Makertech3D/Proforge-2S/README.md

# Proforge-2S
Proforge 2S related files and dowloads.
