Makertech3D/Proforge-2S/Metal Parts/Endstop Trigger.STEP

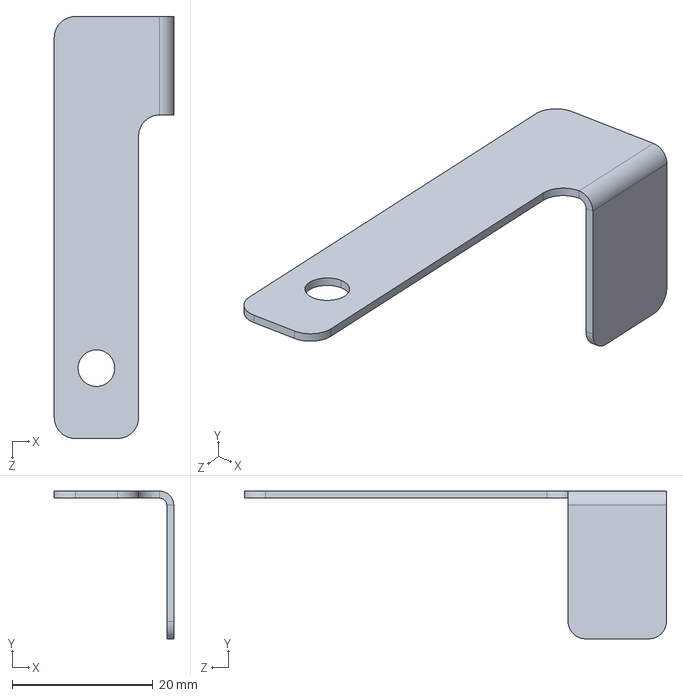
[picture p2: CAD file, 2020-06-16]
Metal Parts/Endstop Trigger.STEP
17.0 x 21.0 x 60.0 mm
