Makertech3D/Proforge-2S/Metal Parts/Pi Cam Case.STEP

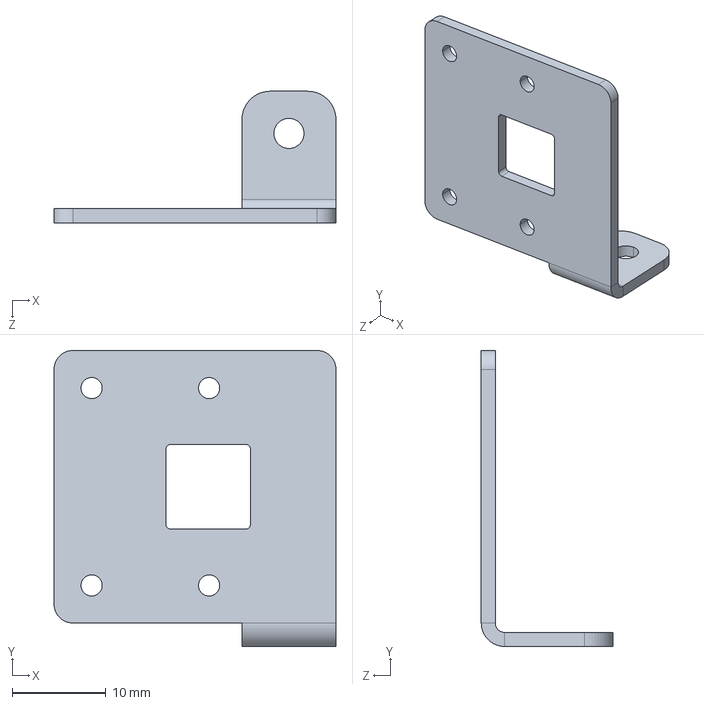
[picture p3: CAD file, 2020-06-16]
Metal Parts/Pi Cam Case.STEP
30.0 x 31.5 x 14.0 mm
