Makertech3D/Proforge-2S/Metal Parts/Y-Idler Support Bracket.STEP

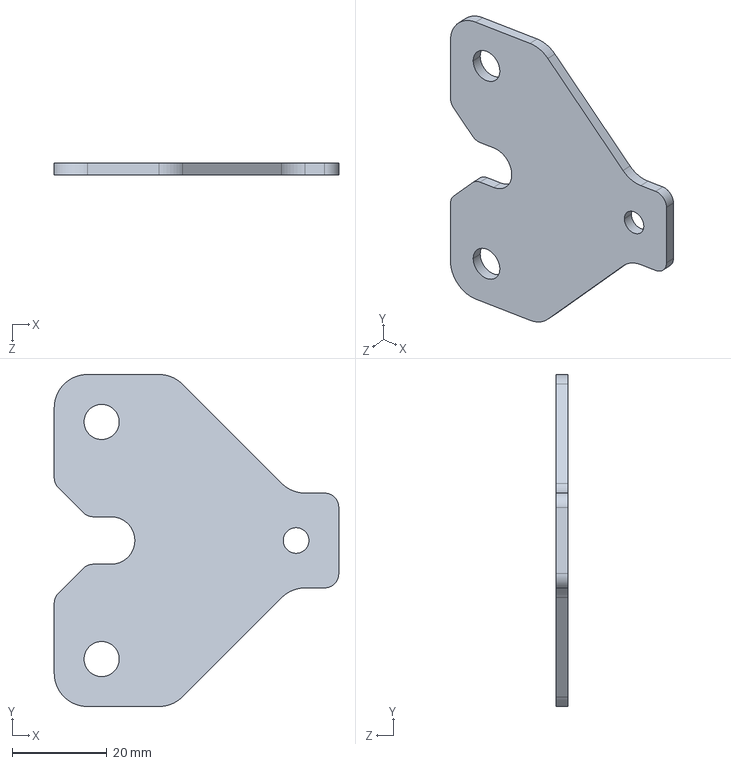
[picture p4: CAD file, 2020-06-16]
Metal Parts/Y-Idler Support Bracket.STEP
60.0 x 70.0 x 2.50 mm
