Makertech3D/Proforge-2S/Metal Parts/DSE Back Plate.STEP

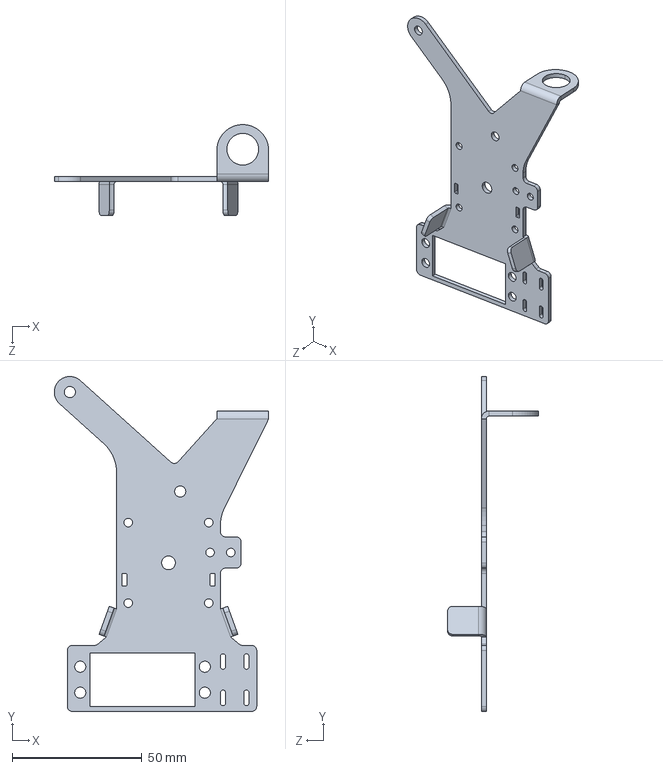
[picture p5: CAD file, 2020-06-16]
Metal Parts/DSE Back Plate.STEP
82.6 x 129.0 x 35.0 mm
