Makertech3D/Proforge-2S/Metal Parts/Y-Idler.STEP

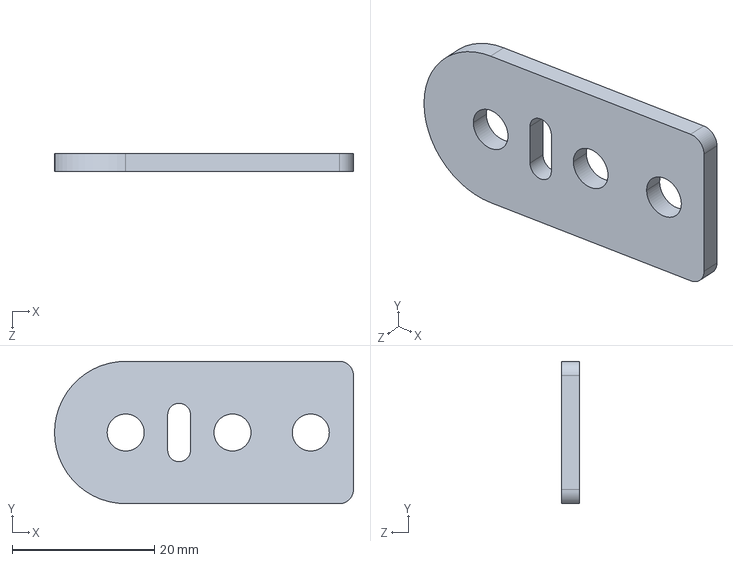
[picture p6: CAD file, 2020-06-16]
Metal Parts/Y-Idler.STEP
42.0 x 20.0 x 2.50 mm
