Makertech3D/Proforge-2S/Metal Parts/DSE 2nd Fan Mount.STEP

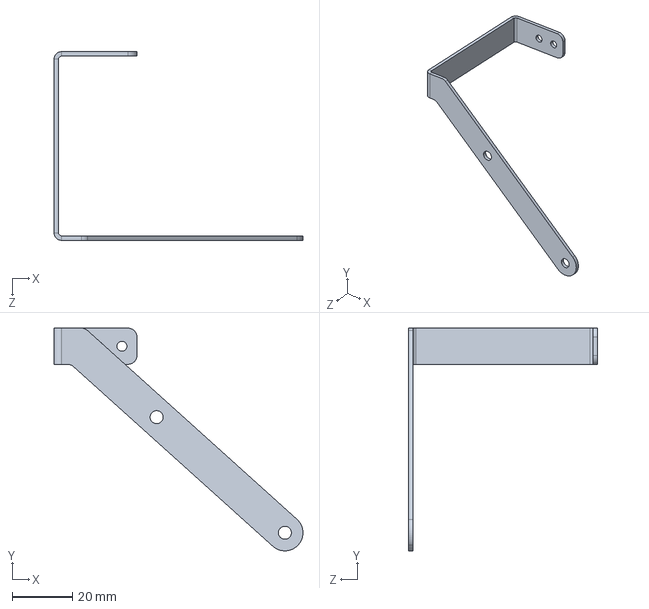
[picture p7: CAD file, 2020-06-16]
Metal Parts/DSE 2nd Fan Mount.STEP
82.5 x 73.8 x 62.5 mm
