Makertech3D/Proforge-2S/Metal Parts/Base Left Panel.STEP

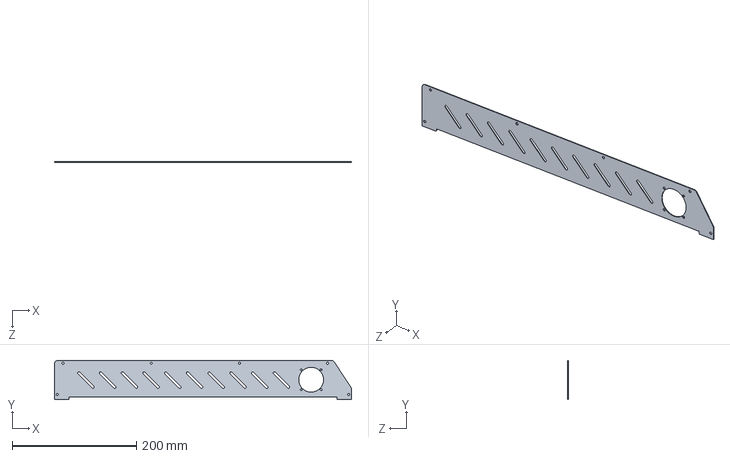
[picture p8: CAD file, 2020-06-16]
Metal Parts/Base Left Panel.STEP
478.6 x 63.0 x 1.00 mm
