Makertech3D/Proforge-2S/Metal Parts/Support Beam.STEP

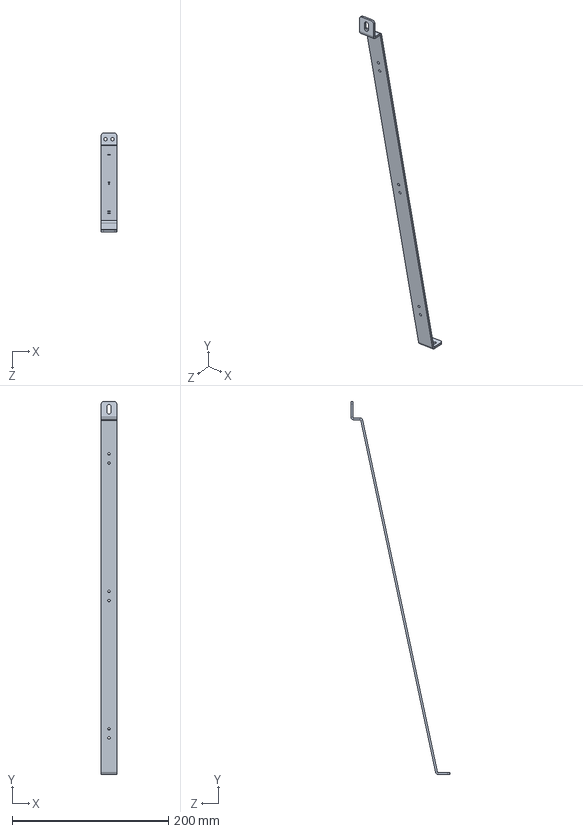
[picture p9: CAD file, 2020-06-16]
Metal Parts/Support Beam.STEP
20.0 x 477.8 x 127.0 mm
