Makertech3D/Proforge-2S/Metal Parts/Tool Carriage.STEP

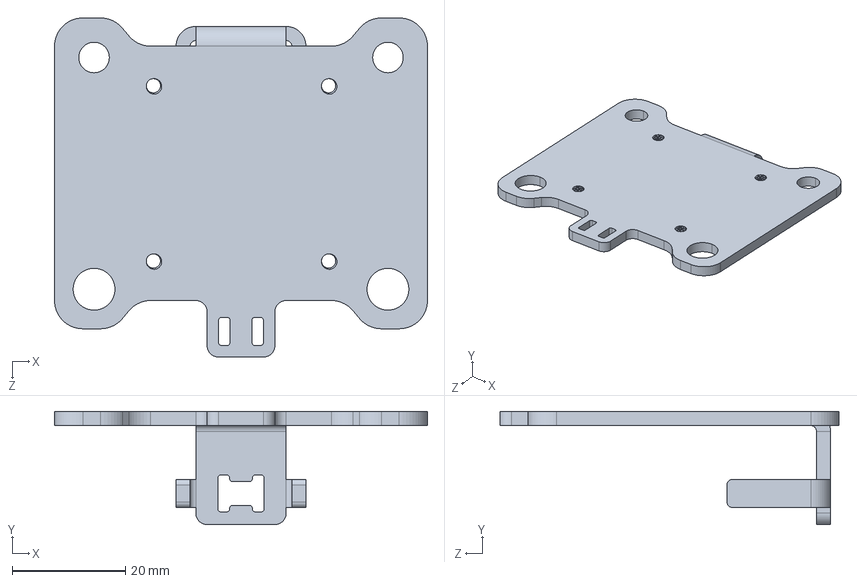
[picture p10: CAD file, 2020-06-16]
Metal Parts/Tool Carriage.STEP
66.0 x 20.0 x 60.0 mm
