Makertech3D/Proforge-2S/Metal Parts/DSE Ooze Shield.STEP

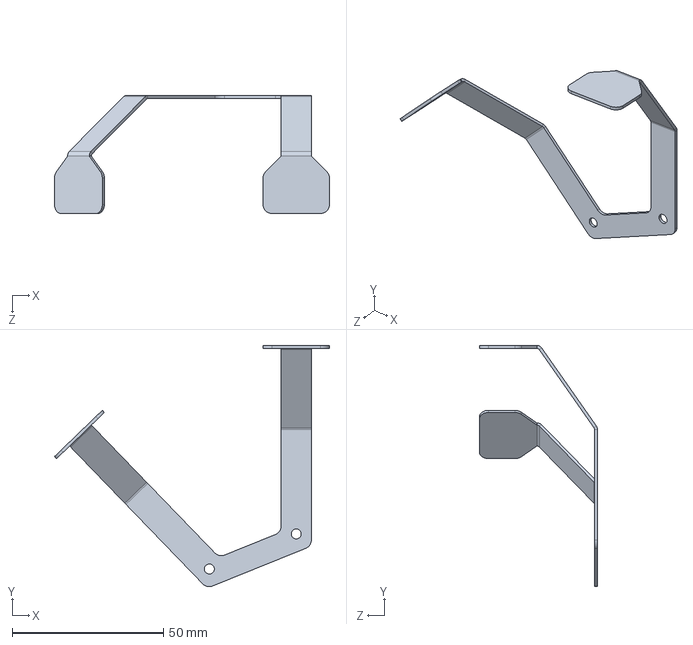
[picture p12: CAD file, 2020-06-16]
Metal Parts/DSE Ooze Shield.STEP
91.0 x 79.8 x 39.1 mm
