Makertech3D/Proforge-2S/Metal Parts/Z-Axis Support Bracket.STEP

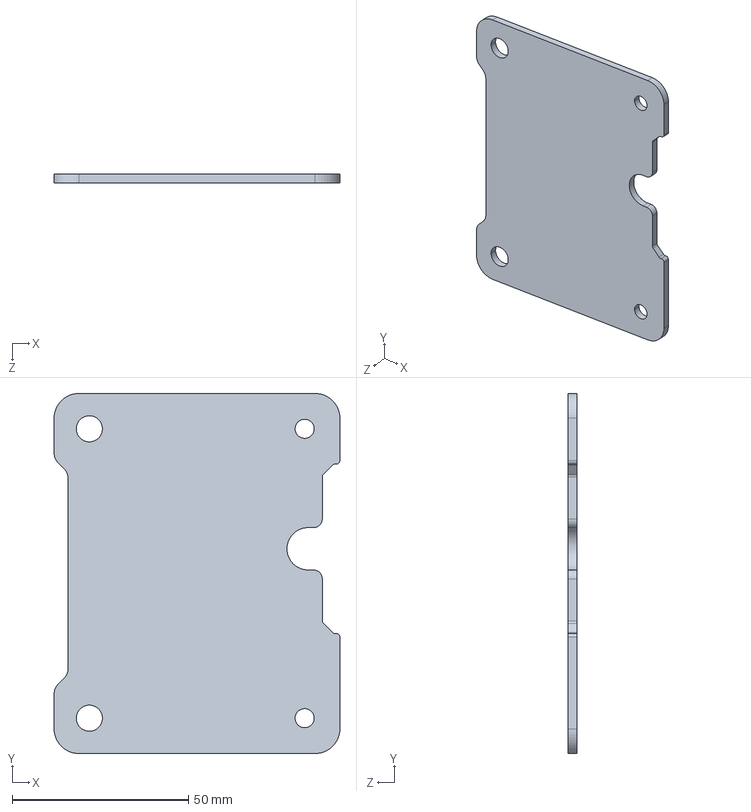
[picture p13: CAD file, 2020-06-16]
Metal Parts/Z-Axis Support Bracket.STEP
81.0 x 102.0 x 2.50 mm
