Makertech3D/Proforge-2S/Metal Parts/Extrusion bracket.STEP

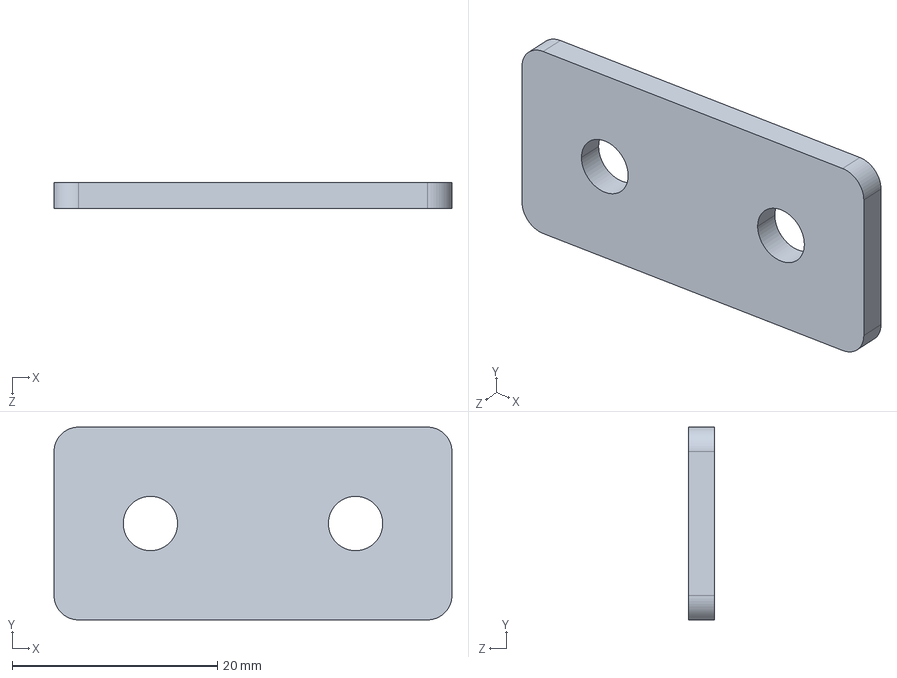
[picture p14: CAD file, 2020-06-16]
Metal Parts/Extrusion bracket.STEP
38.8 x 18.8 x 2.50 mm
