Makertech3D/Proforge-2S/Metal Parts/Print Platform.STEP

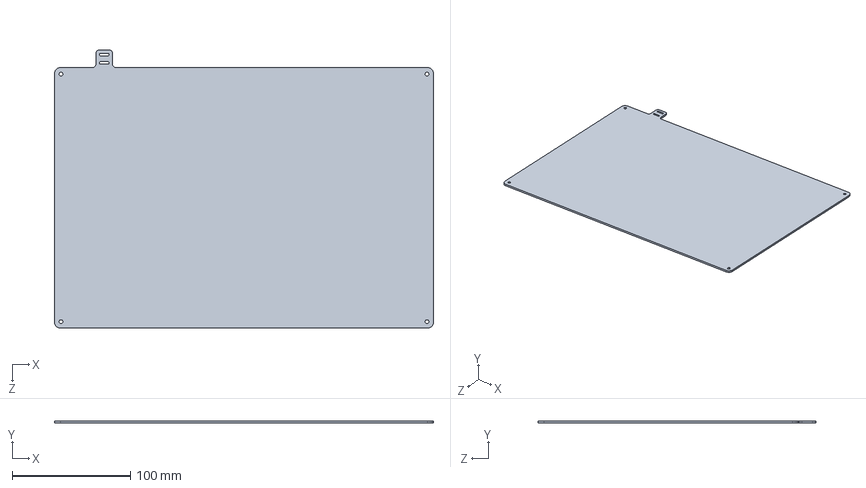
[picture p15: CAD file, 2020-06-16]
Metal Parts/Print Platform.STEP
320.0 x 2.00 x 235.0 mm
