Makertech3D/Proforge-2S/Metal Parts/Base.STEP

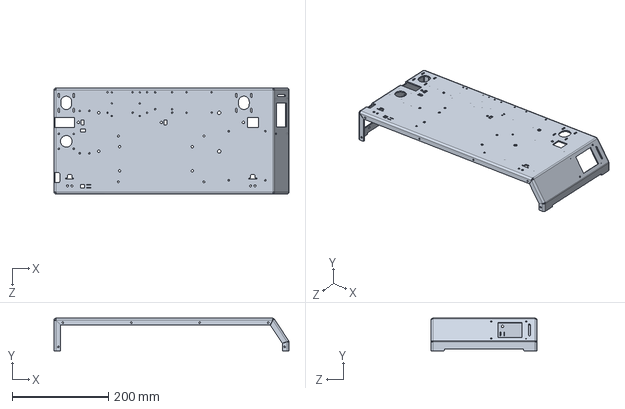
[picture p16: CAD file, 2020-06-16]
Metal Parts/Base.STEP
487.6 x 67.5 x 220.0 mm
