Makertech3D/Proforge-2S/Metal Parts/Z-Axis Bracket.STEP

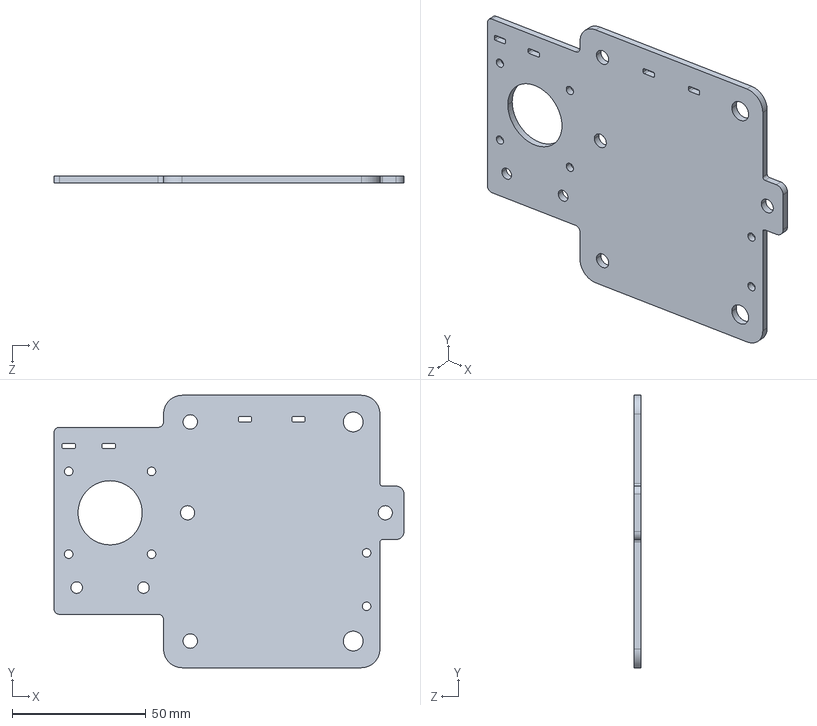
[picture p17: CAD file, 2020-06-16]
Metal Parts/Z-Axis Bracket.STEP
131.0 x 102.0 x 2.50 mm
