Makertech3D/Proforge-2S/Metal Parts/DSE Hotend Mount.STEP

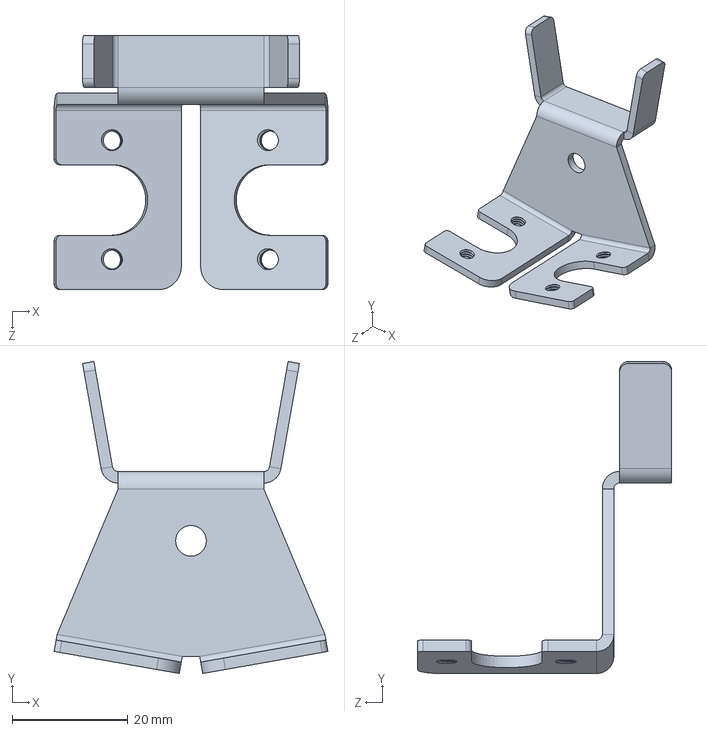
[picture p18: CAD file, 2020-06-16]
Metal Parts/DSE Hotend Mount.STEP
47.4 x 54.0 x 44.0 mm
