Makertech3D/Proforge-2S/Metal Parts/Y-Idler Guided.STEP

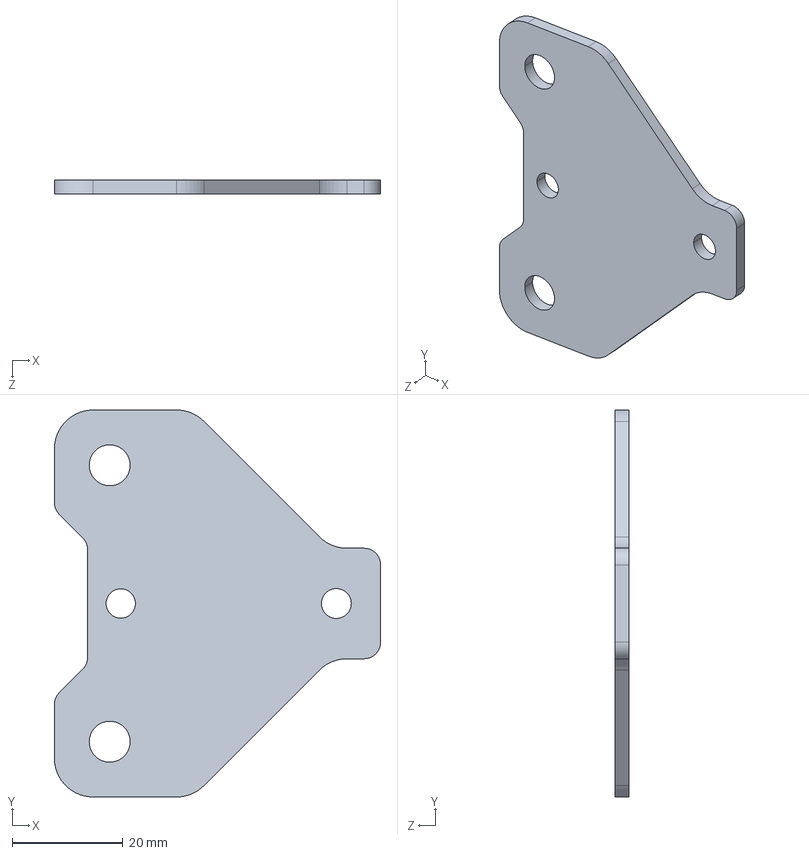
[picture p19: CAD file, 2020-06-16]
Metal Parts/Y-Idler Guided.STEP
59.0 x 70.0 x 2.50 mm
