Makertech3D/Proforge-2S/Metal Parts/Pi Cam Mount.STEP

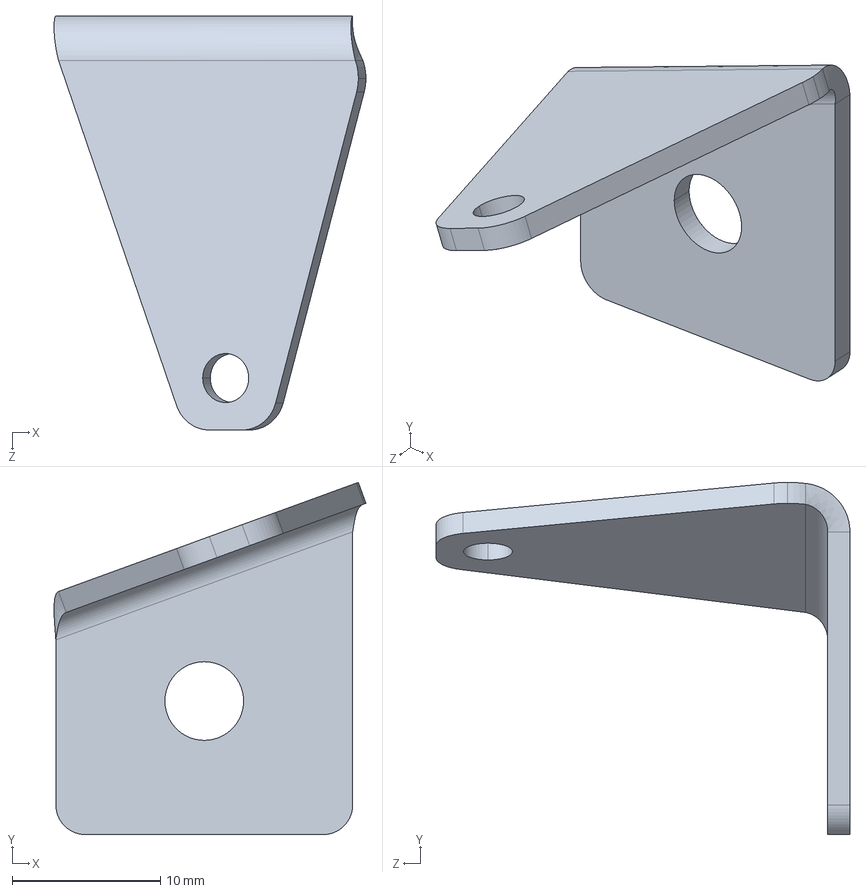
[picture p20: CAD file, 2020-06-16]
Metal Parts/Pi Cam Mount.STEP
21.0 x 23.7 x 27.9 mm
