Makertech3D/Proforge-2S/Metal Parts/Spool Holder.STEP

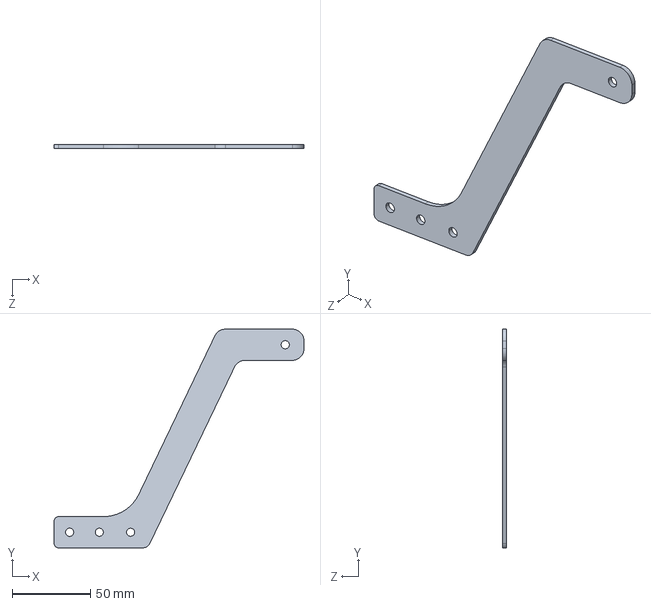
[picture p21: CAD file, 2020-06-16]
Metal Parts/Spool Holder.STEP
160.0 x 140.0 x 2.50 mm
