Makertech3D/Proforge-2S/Metal Parts/Hotend Mount.STEP

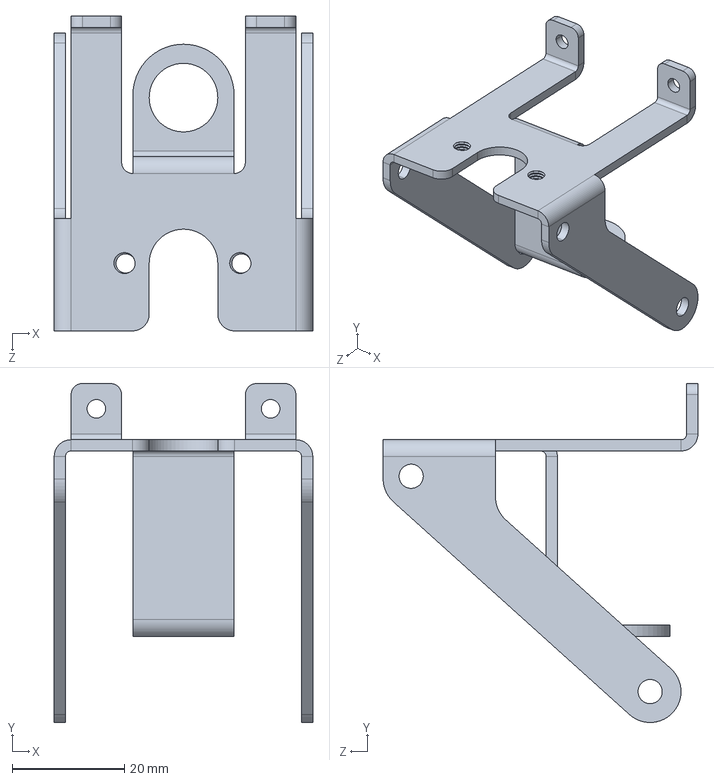
[picture p22: CAD file, 2020-06-16]
Metal Parts/Hotend Mount.STEP
46.0 x 60.3 x 56.0 mm
