Makertech3D/Proforge-2S/Metal Parts/Feeder Mount.STEP

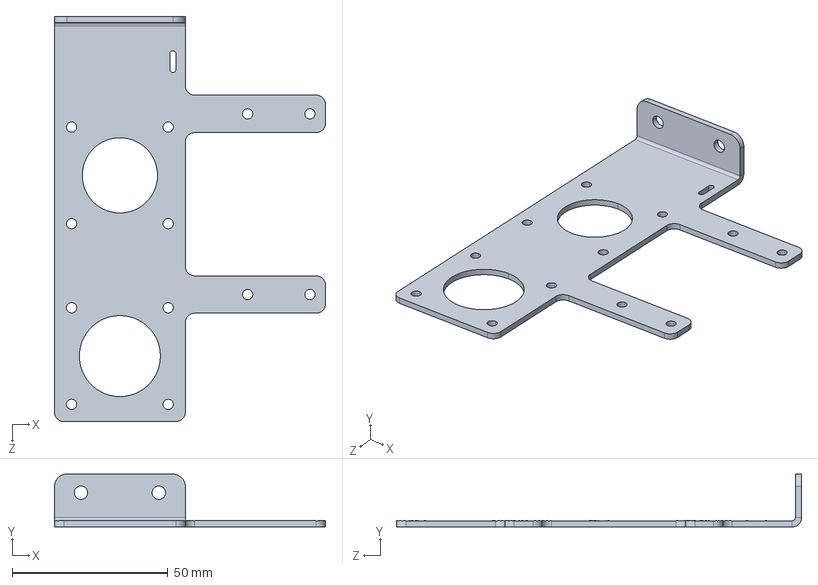
[picture p23: CAD file, 2020-06-16]
Metal Parts/Feeder Mount.STEP
87.0 x 17.0 x 130.0 mm
