Makertech3D/Proforge-2S/Metal Parts/Base Left Panel.PDF

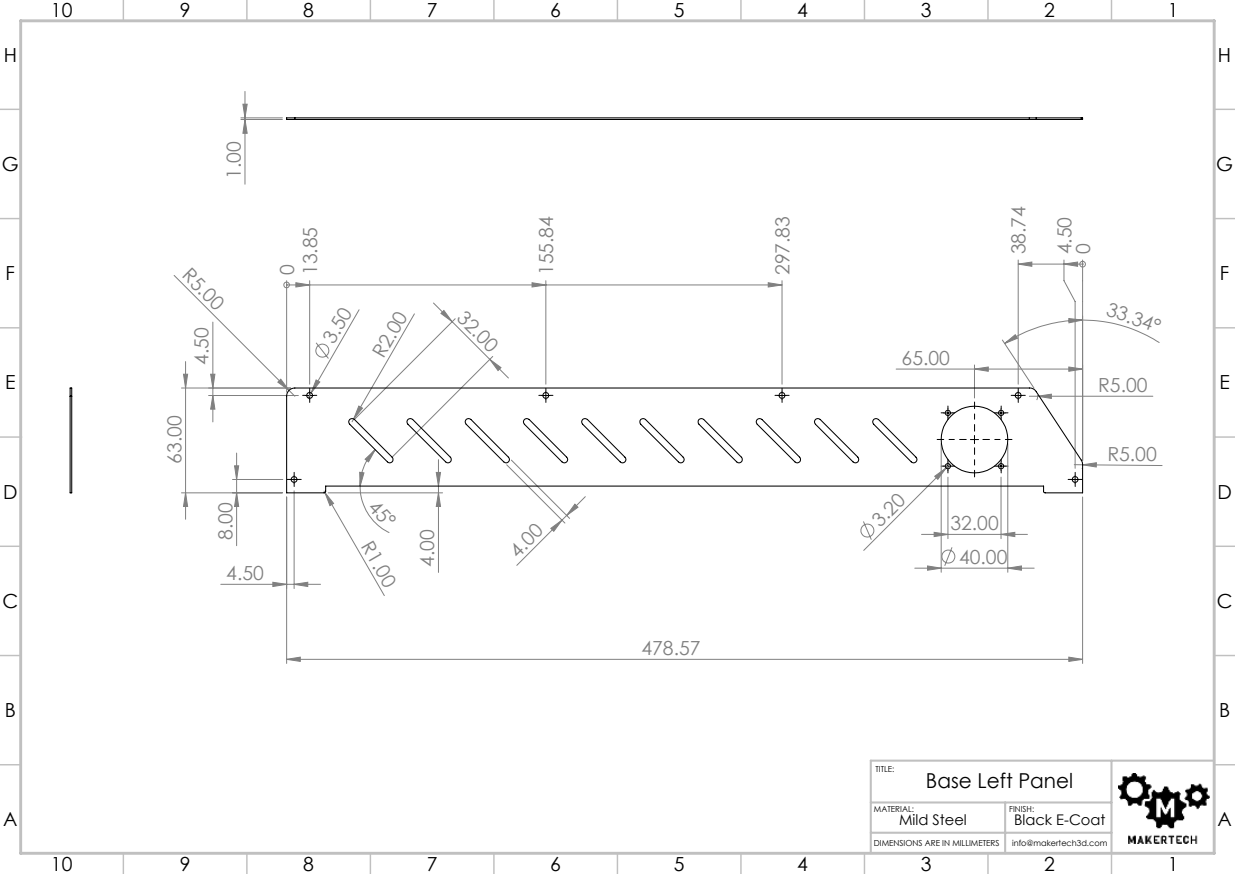
[picture p24: page 1]
Mild Steel

TITLE: Base Left Panel

MATERIAL: | FINISH: Black E-Coat

DIMENSIONS ARE IN MILLIMETERS | info@makertech3d.com
