Makertech3D/Proforge-2S/Metal Parts/Base Right Panel.PDF

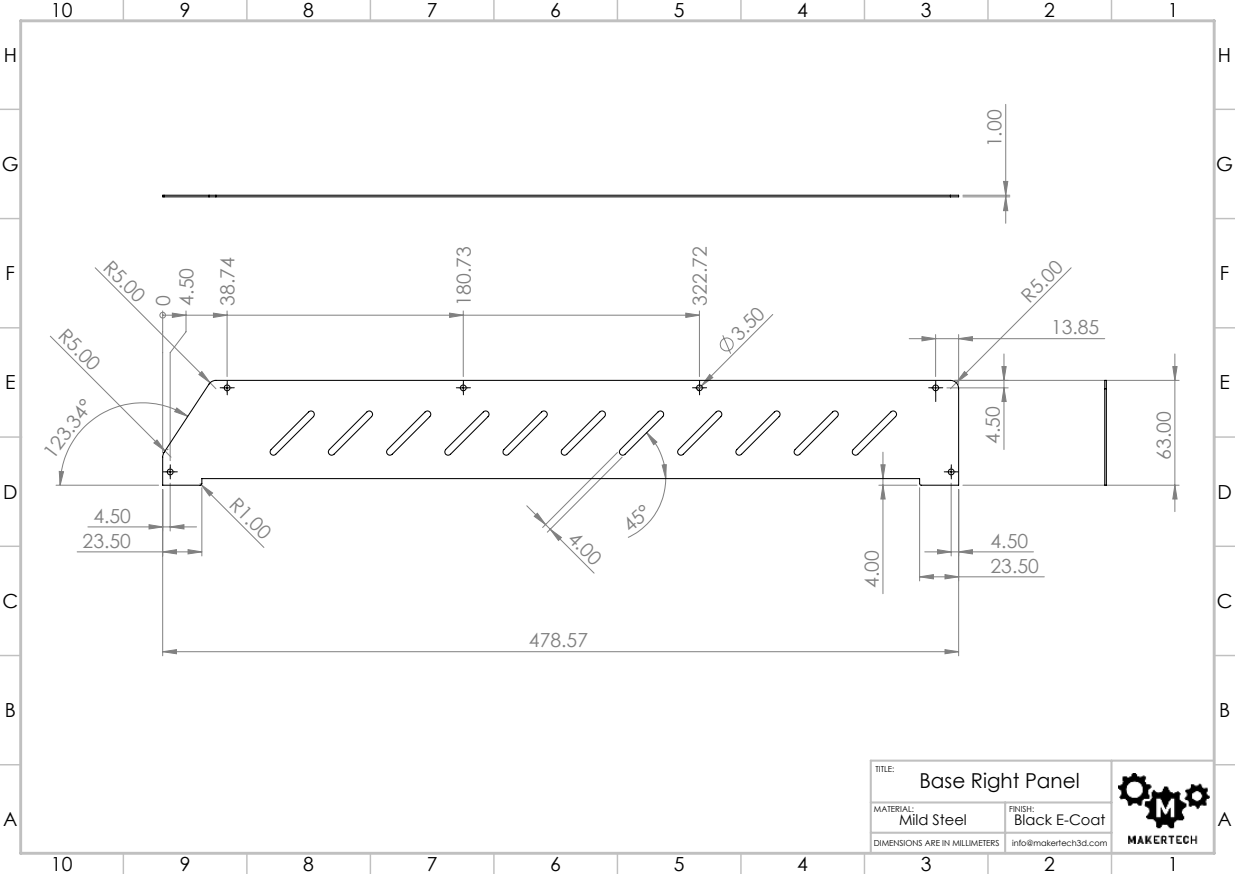
[picture p25: page 1]
Mild Steel

TITLE: Base Right Panel

MATERIAL: | FINISH: Black E-Coat

DIMENSIONS ARE IN MILLIMETERS | info@makertech3d.com
