Makertech3D/Proforge-2S/Metal Parts/Base.PDF

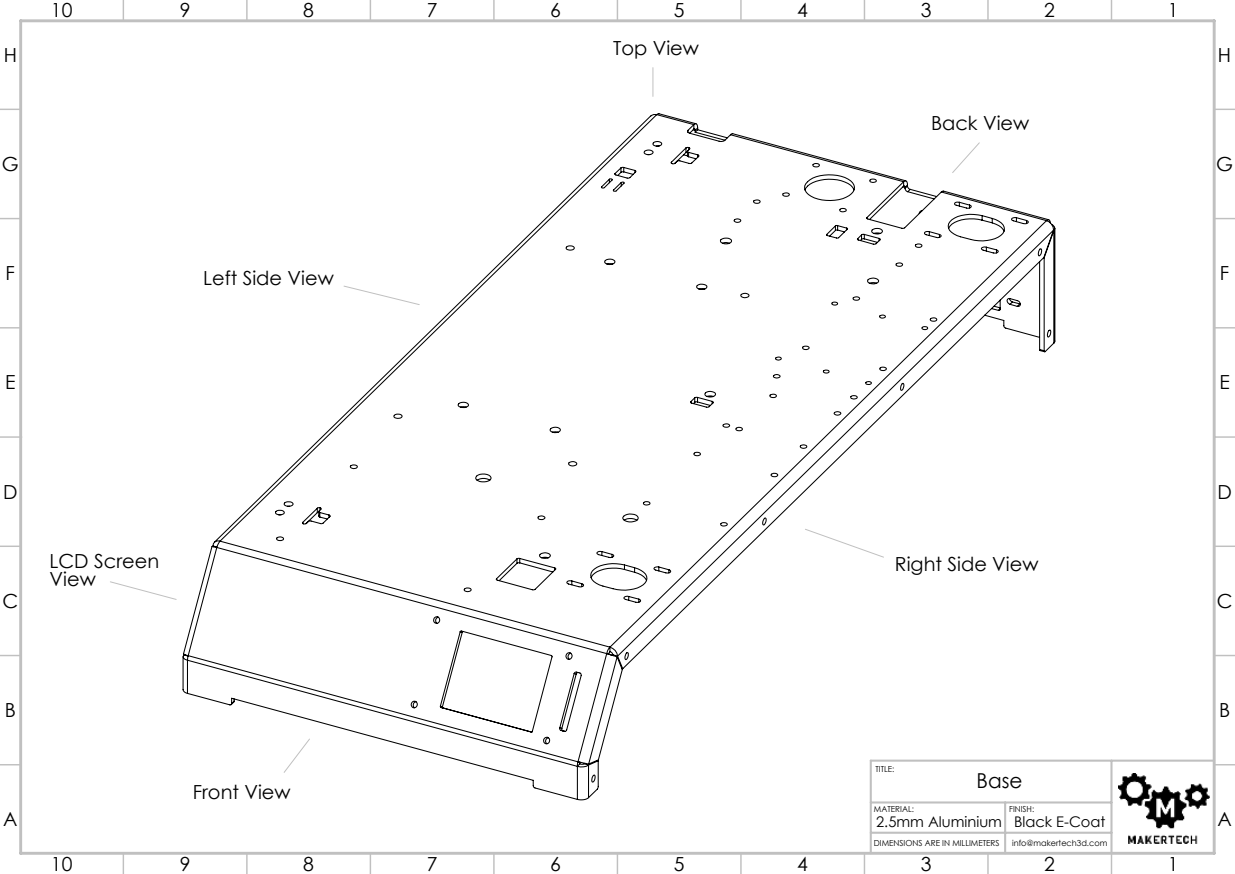
[picture p26: page 1]
Front View; Back View; Top View; LCD Screen; 2.5mm Aluminium; Black E-Coat

Left Side View

Right Side View

TITLE: Base

MATERIAL: | FINISH:

DIMENSIONS ARE IN MILLIMETERS | info@makertech3d.com

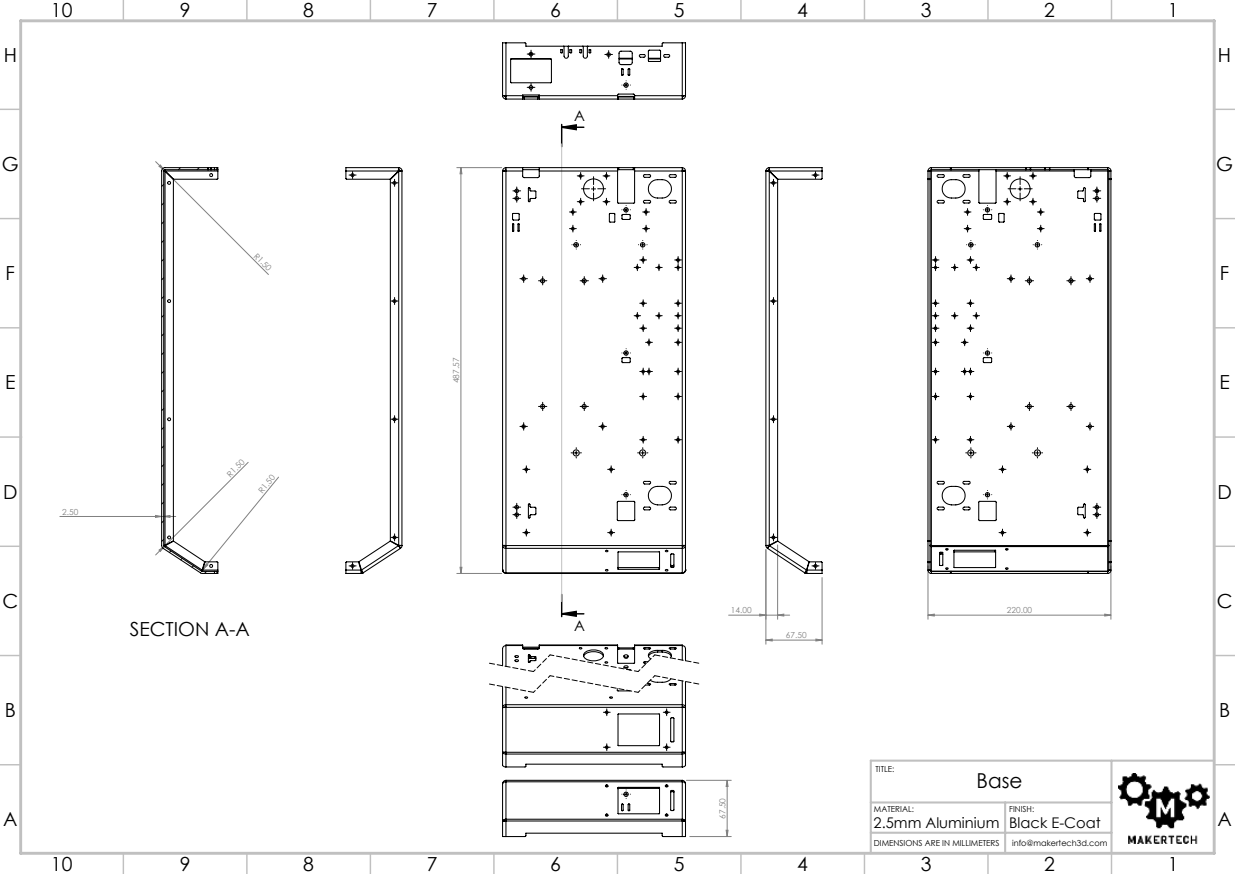
[picture p27: page 2]
SECTION A-A; 2.5mm Aluminium

TITLE: Base

Black E-Coat

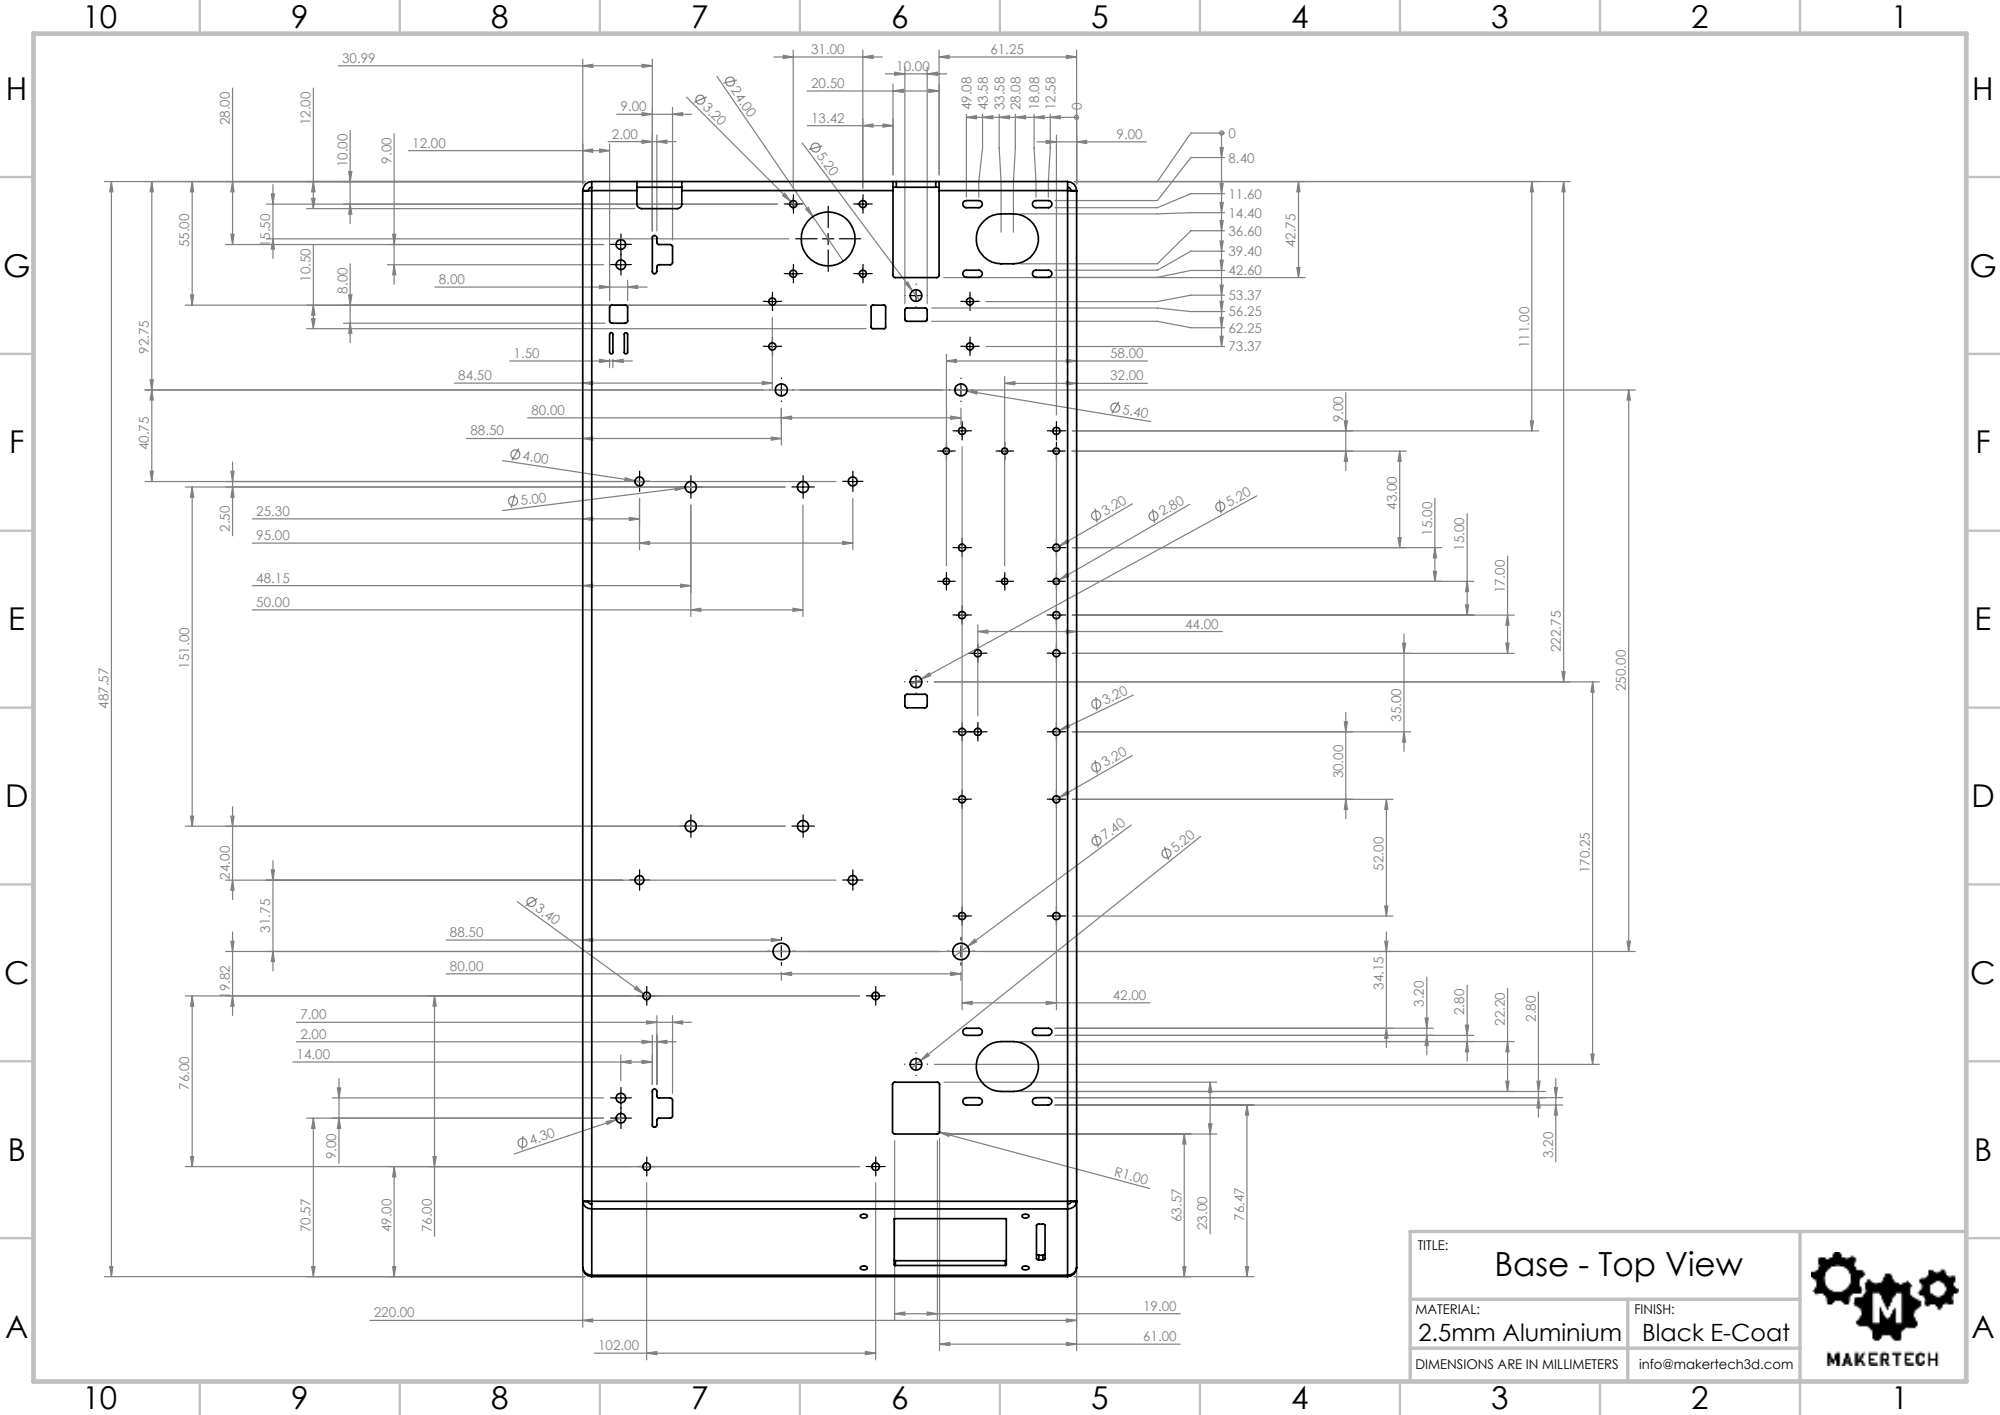
[picture p28: page 3]
2.5mm Aluminium; Black E-Coat

TITLE:
Base - Top View

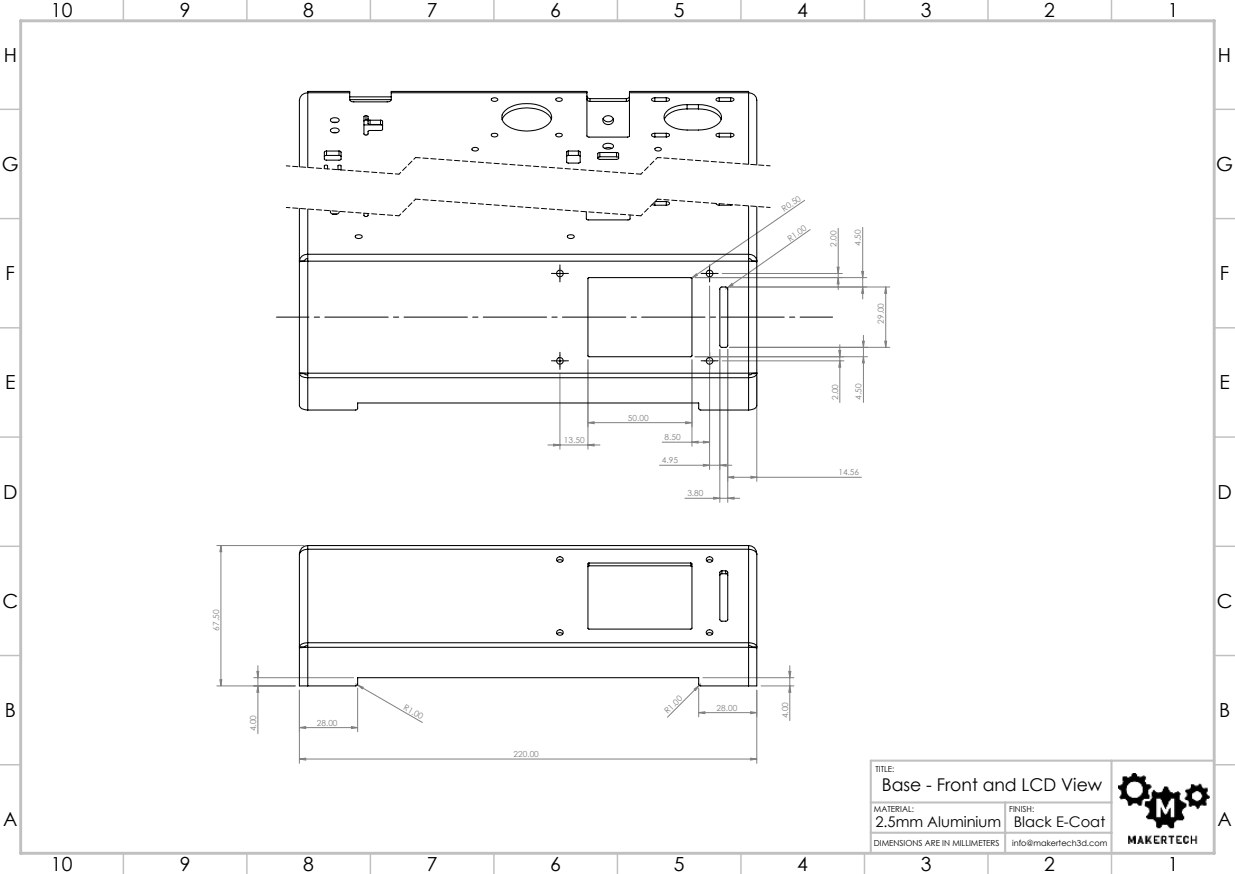
[picture p29: page 4]

TITLE:
Base - Front and LCD View

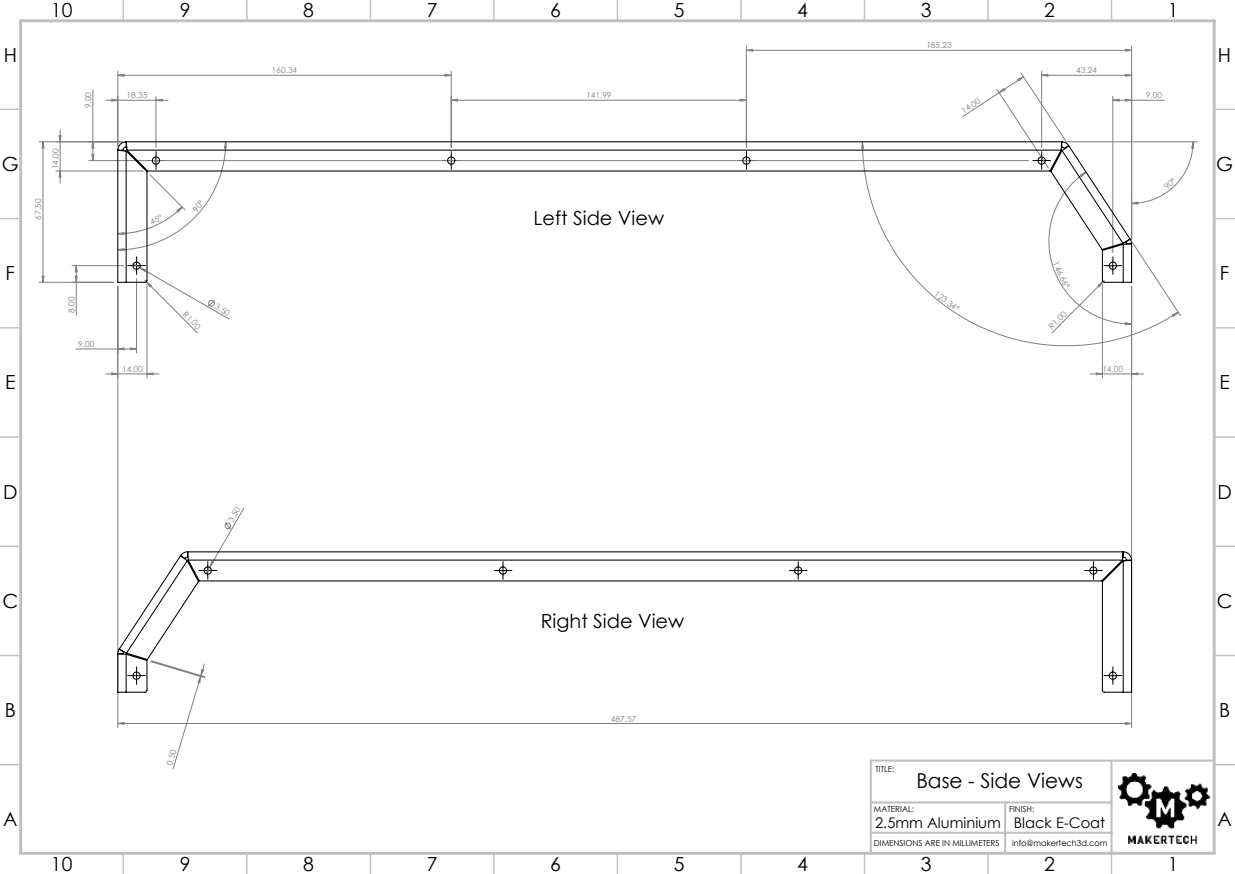
[picture p30: page 5]

Left Side View

Right Side View

TITLE:
Base - Side Views

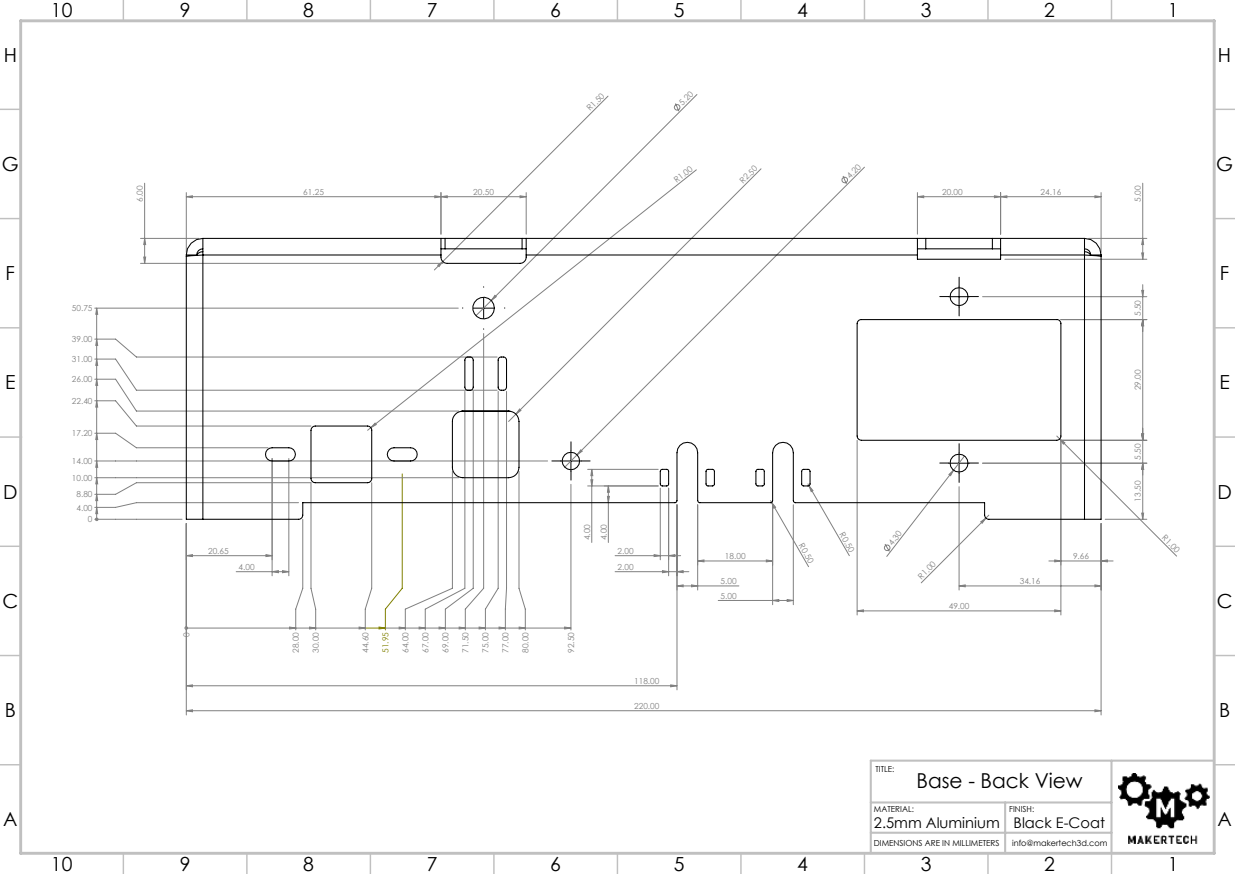
[picture p31: page 6]

TITLE:
Base - Back View
