Makertech3D/Proforge-2S/Metal Parts/DSE 2nd Fan Mount.PDF

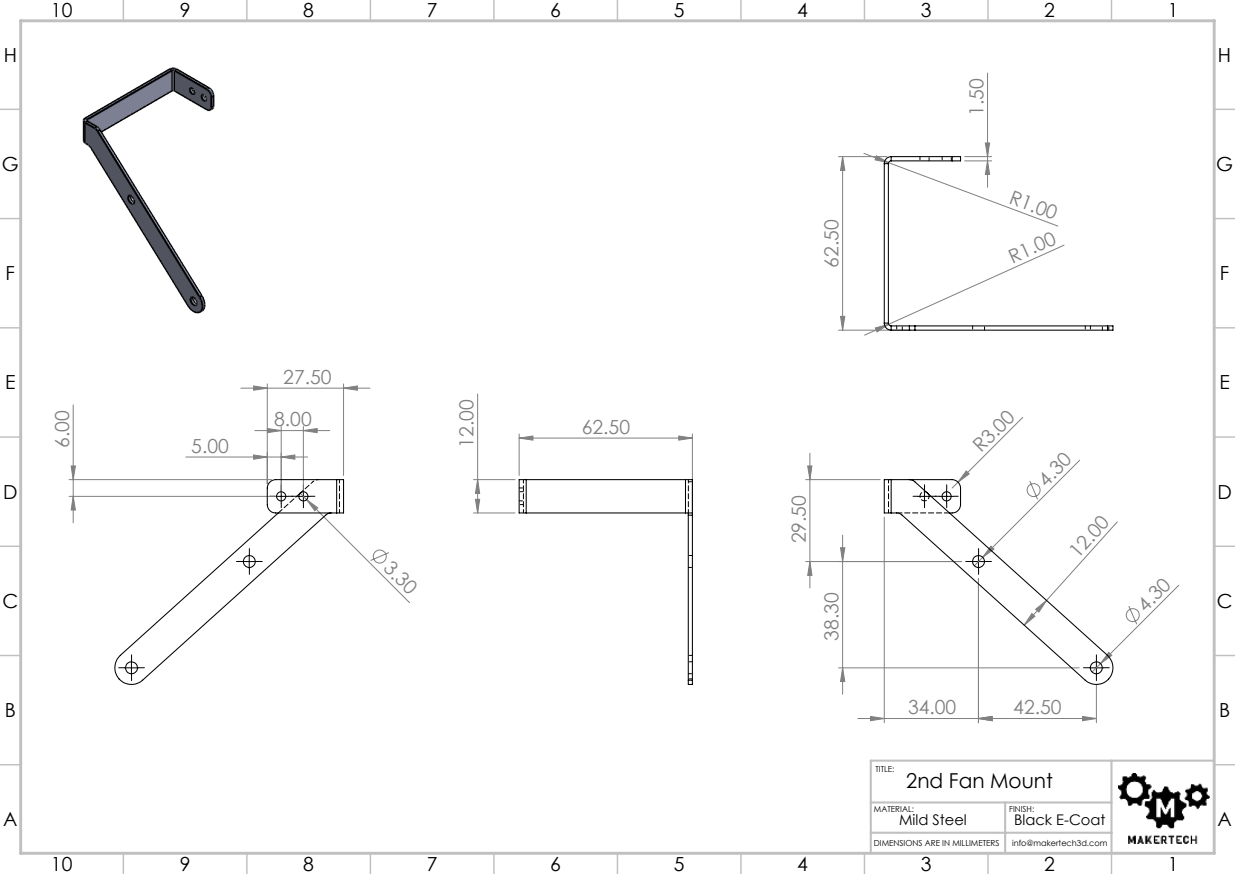
[picture p32: page 1]
Mild Steel

TITLE: 2nd Fan Mount

MATERIAL: | FINISH: Black E-Coat

DIMENSIONS ARE IN MILLIMETERS | info@makertech3d.com
