Makertech3D/Proforge-2S/Metal Parts/DSE Back Plate.PDF

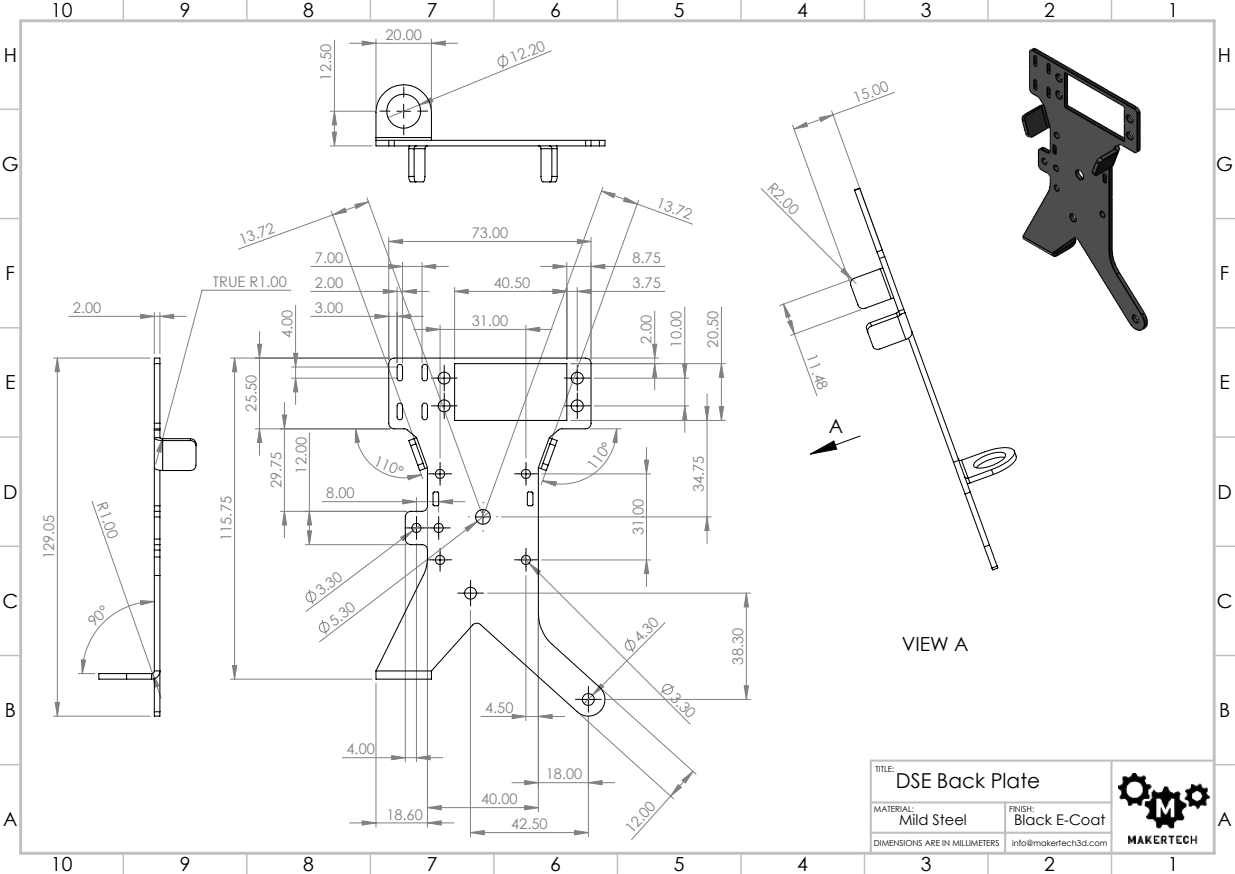
[picture p33: page 1]
TRUE R1.00; VIEW A; Mild Steel

TITLE: DSE Back Plate

MATERIAL: | FINISH: Black E-Coat

DIMENSIONS ARE IN MILLIMETERS | info@makertech3d.com
