Makertech3D/Proforge-2S/Metal Parts/DSE Hotend Mount.PDF

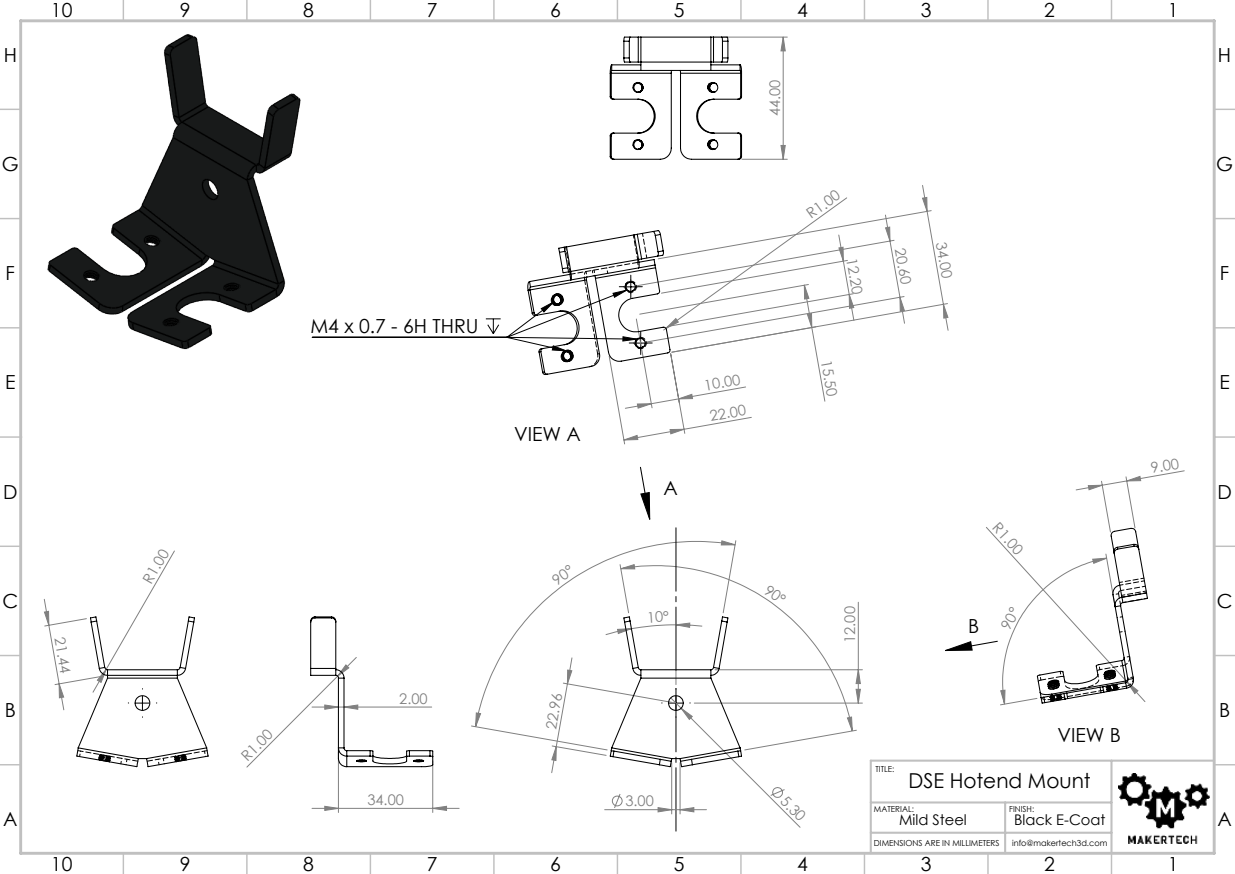
[picture p34: page 1]
VIEW B; VIEW A; M4 x 0.7 - 6H THRU; Mild Steel; Black E-Coat

TITLE: DSE Hotend Mount

MATERIAL: | FINISH:

DIMENSIONS ARE IN MILLIMETERS | info@makertech3d.com
