Makertech3D/Proforge-2S/Metal Parts/DSE Ooze Shield.PDF

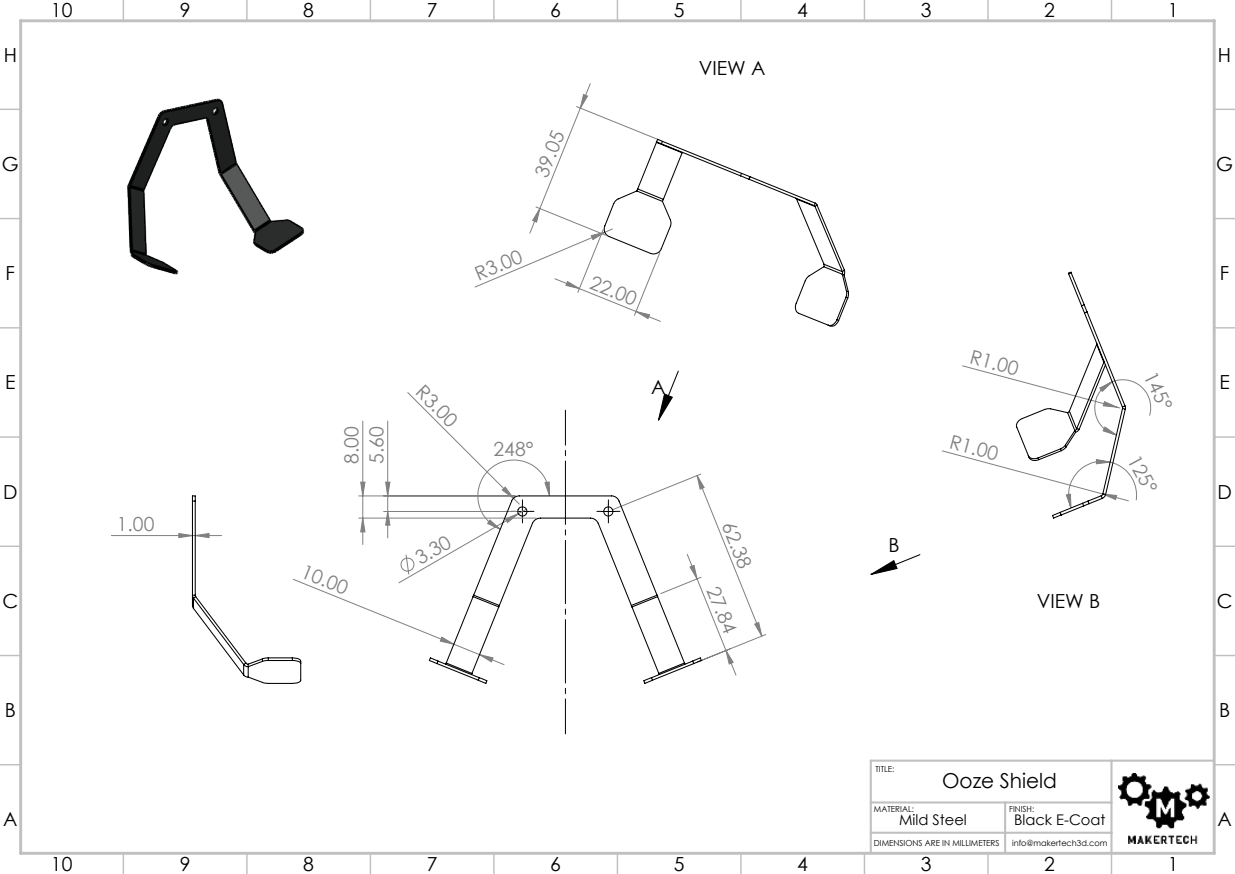
[picture p35: page 1]
VIEW A; VIEW B; Mild Steel

TITLE: Ooze Shield

MATERIAL: | FINISH: Black E-Coat

DIMENSIONS ARE IN MILLIMETERS | info@makertech3d.com
