Makertech3D/Proforge-2S/Metal Parts/Endstop Trigger.PDF

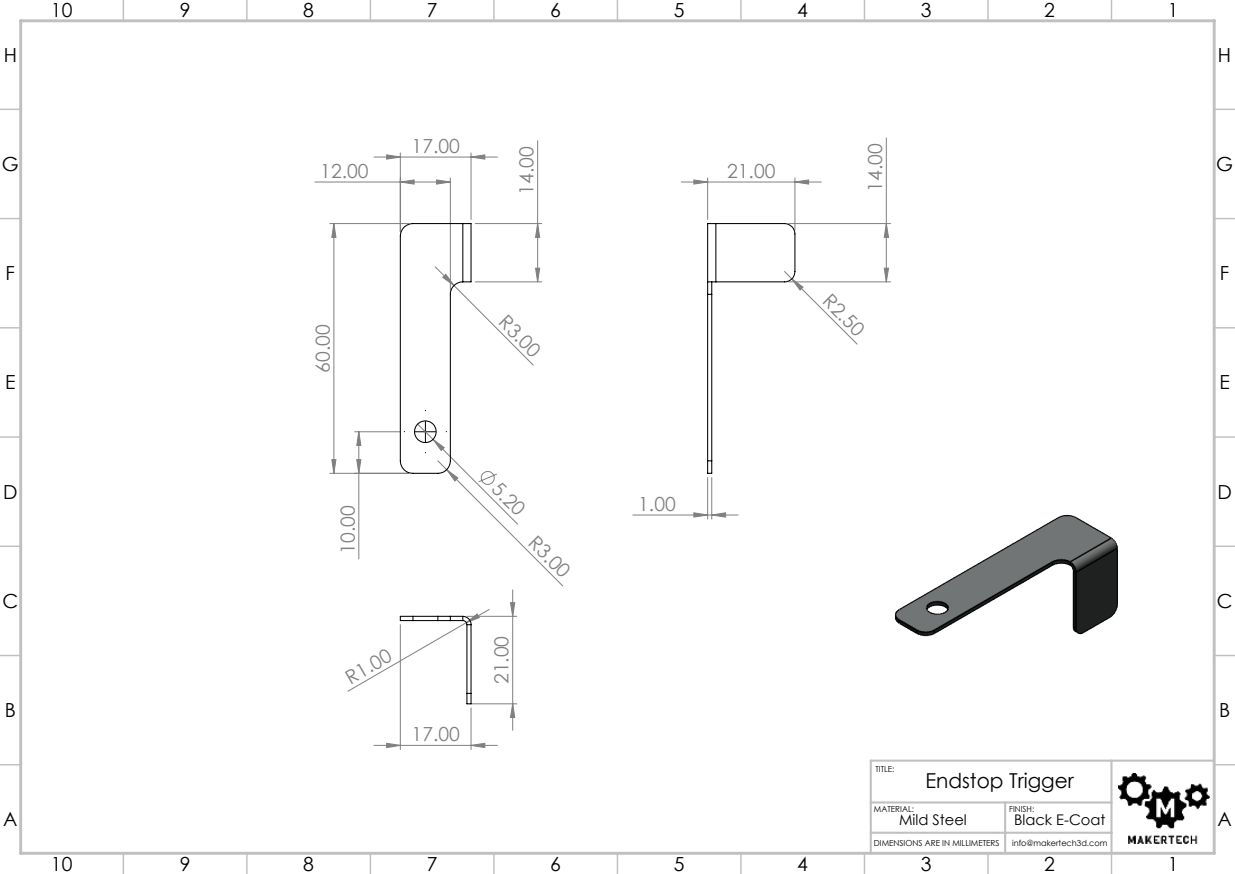
[picture p36: page 1]
Mild Steel

TITLE: Endstop Trigger

MATERIAL: | FINISH: Black E-Coat

DIMENSIONS ARE IN MILLIMETERS | info@makertech3d.com
