Makertech3D/Proforge-2S/Metal Parts/Extrusion Bracket.PDF

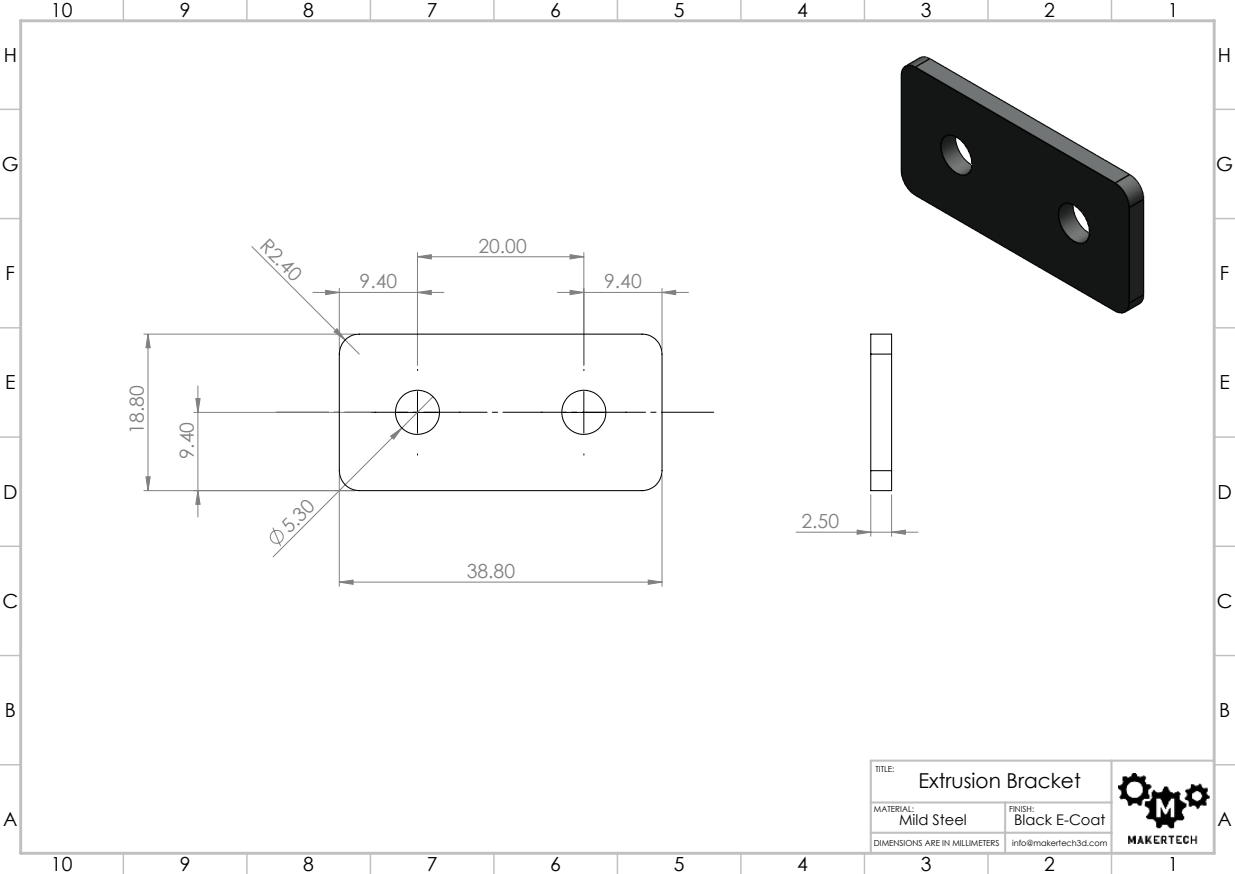
[picture p37: page 1]
Mild Steel

TITLE: Extrusion Bracket

MATERIAL: | FINISH: Black E-Coat

DIMENSIONS ARE IN MILLIMETERS | info@makertech3d.com
