Makertech3D/Proforge-2S/Metal Parts/Feeder Mount.PDF

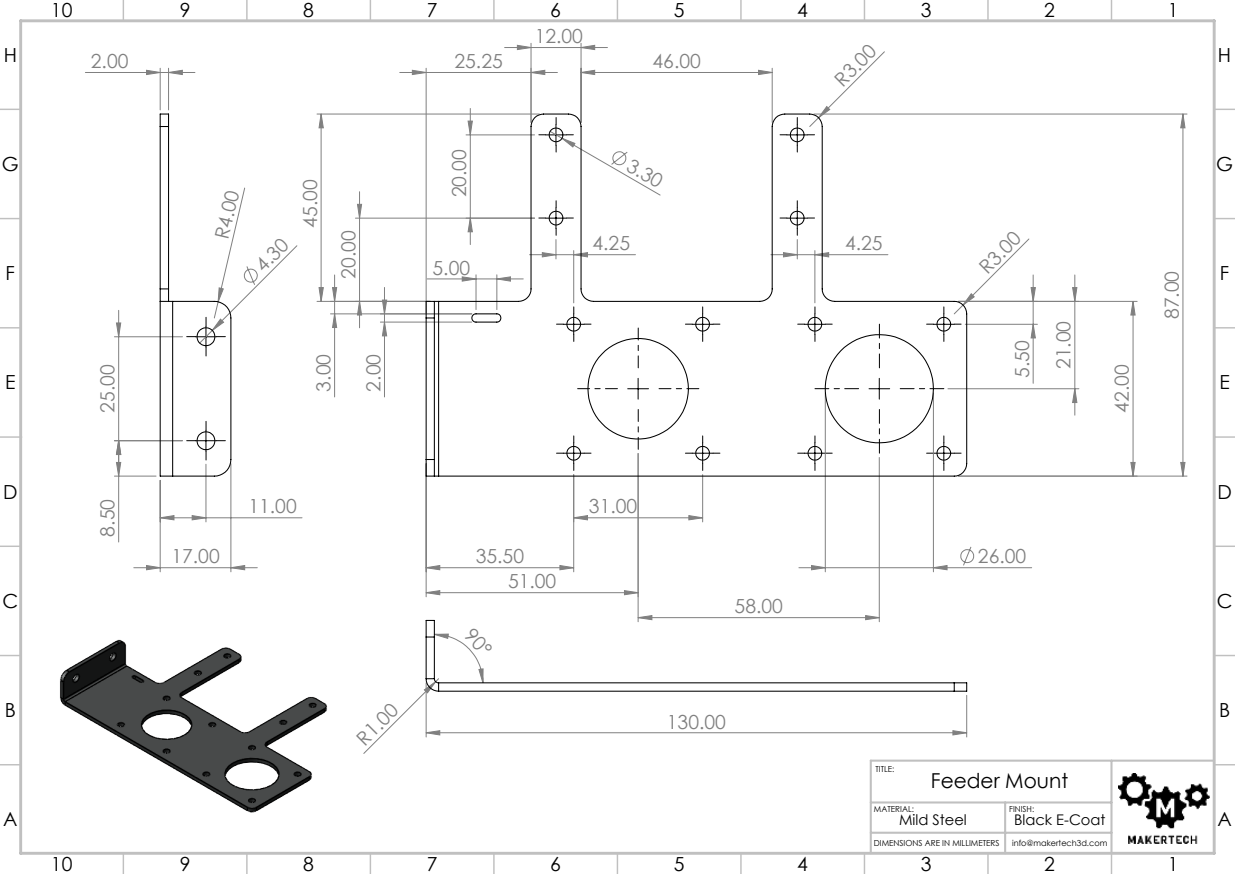
[picture p38: page 1]
Mild Steel; Black E-Coat

TITLE: Feeder Mount

MATERIAL: | FINISH:

DIMENSIONS ARE IN MILLIMETERS | info@makertech3d.com
