Makertech3D/Proforge-2S/Metal Parts/Hotend Mount.PDF

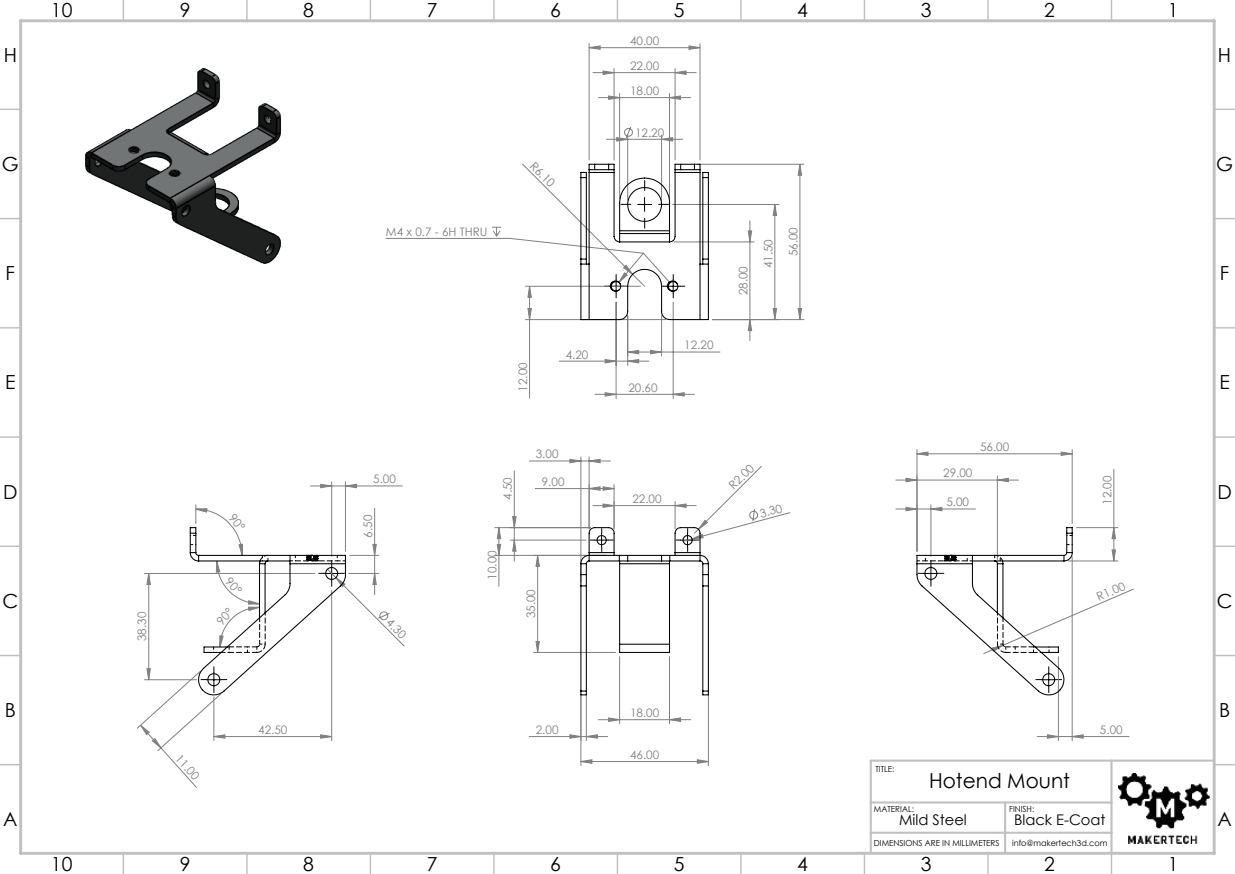
[picture p39: page 1]
M4 x 0.7 - 6H THRU; Mild Steel

TITLE: Hotend Mount

MATERIAL: | FINISH: Black E-Coat

DIMENSIONS ARE IN MILLIMETERS | info@makertech3d.com
