Makertech3D/Proforge-2S/Metal Parts/Pi Cam Case.PDF

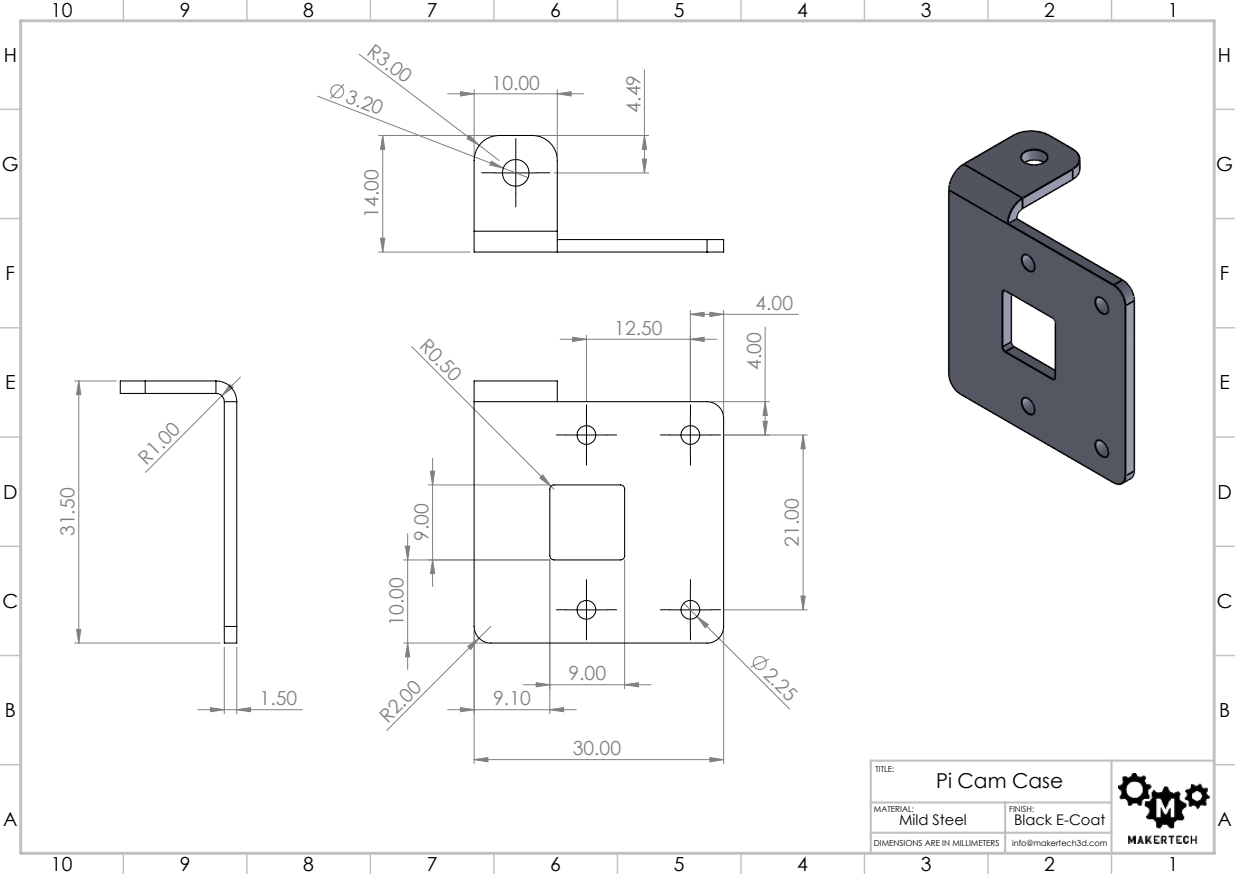
[picture p40: page 1]
Mild Steel

TITLE: Pi Cam Case

MATERIAL: | FINISH: Black E-Coat

DIMENSIONS ARE IN MILLIMETERS | info@makertech3d.com
