Makertech3D/Proforge-2S/Metal Parts/Pi Cam Mount.PDF

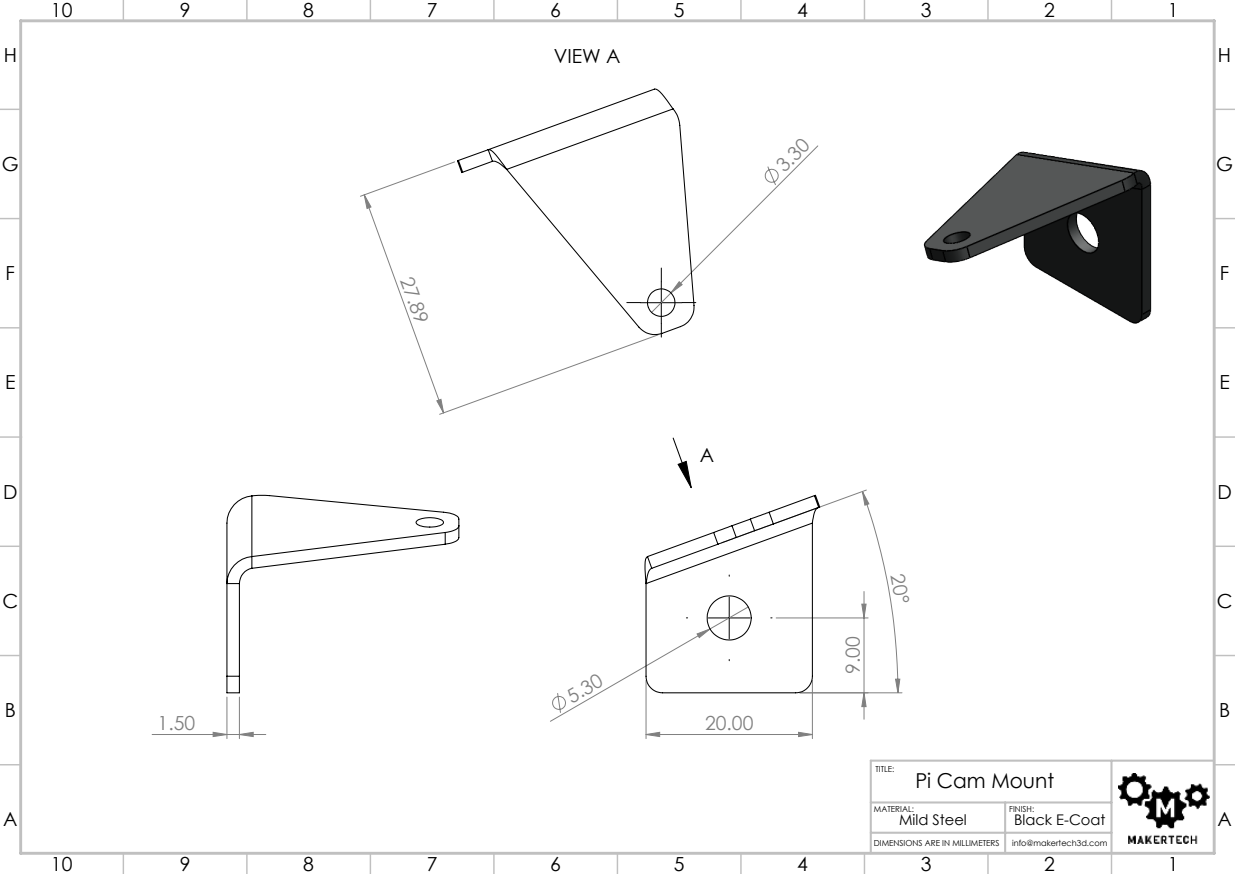
[picture p41: page 1]
VIEW A; Mild Steel

TITLE: Pi Cam Mount

MATERIAL: | FINISH: Black E-Coat

DIMENSIONS ARE IN MILLIMETERS | info@makertech3d.com
