Makertech3D/Proforge-2S/Metal Parts/Print Platform.PDF

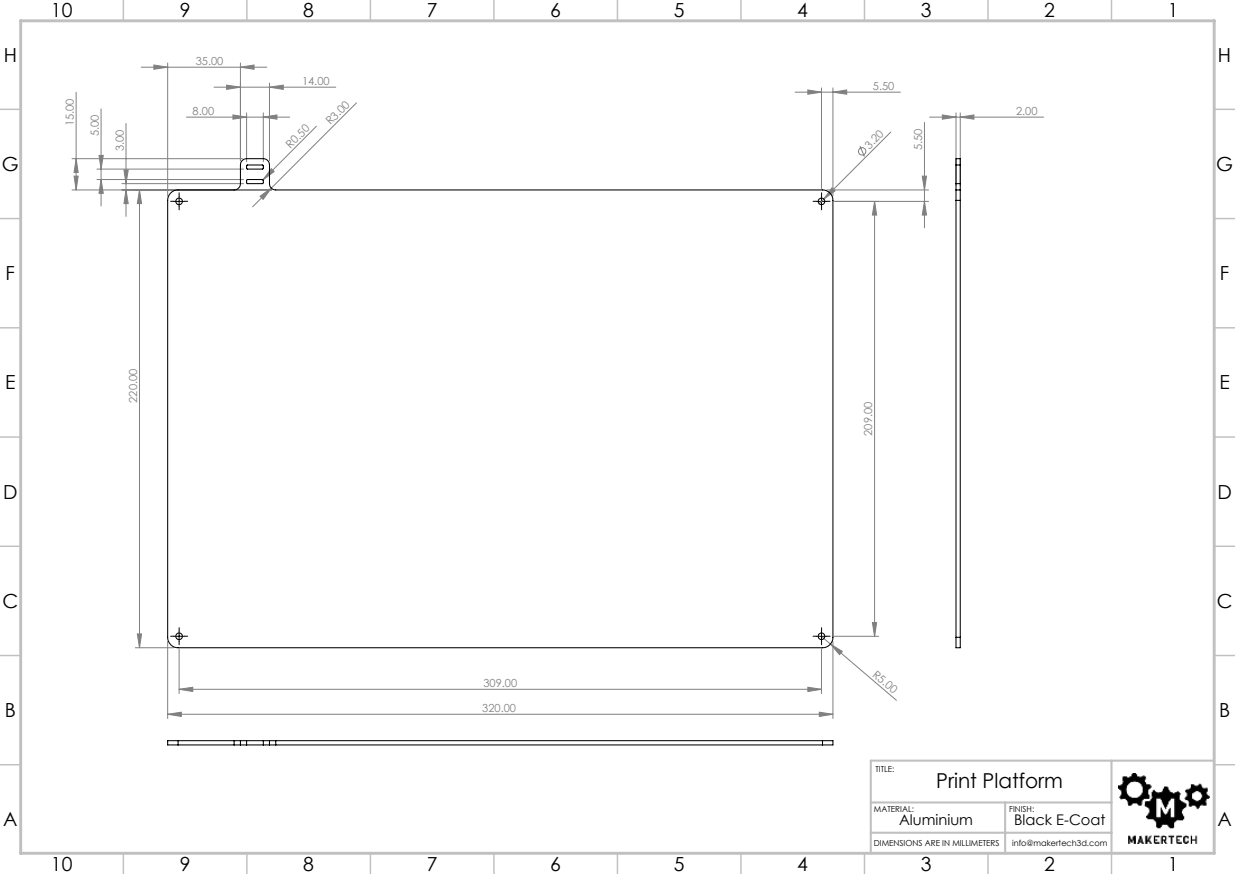
[picture p42: page 1]

TITLE: Print Platform

MATERIAL: | FINISH: Black E-Coat

DIMENSIONS ARE IN MILLIMETERS | info@makertech3d.com
