Makertech3D/Proforge-2S/Metal Parts/Spool Holder.PDF

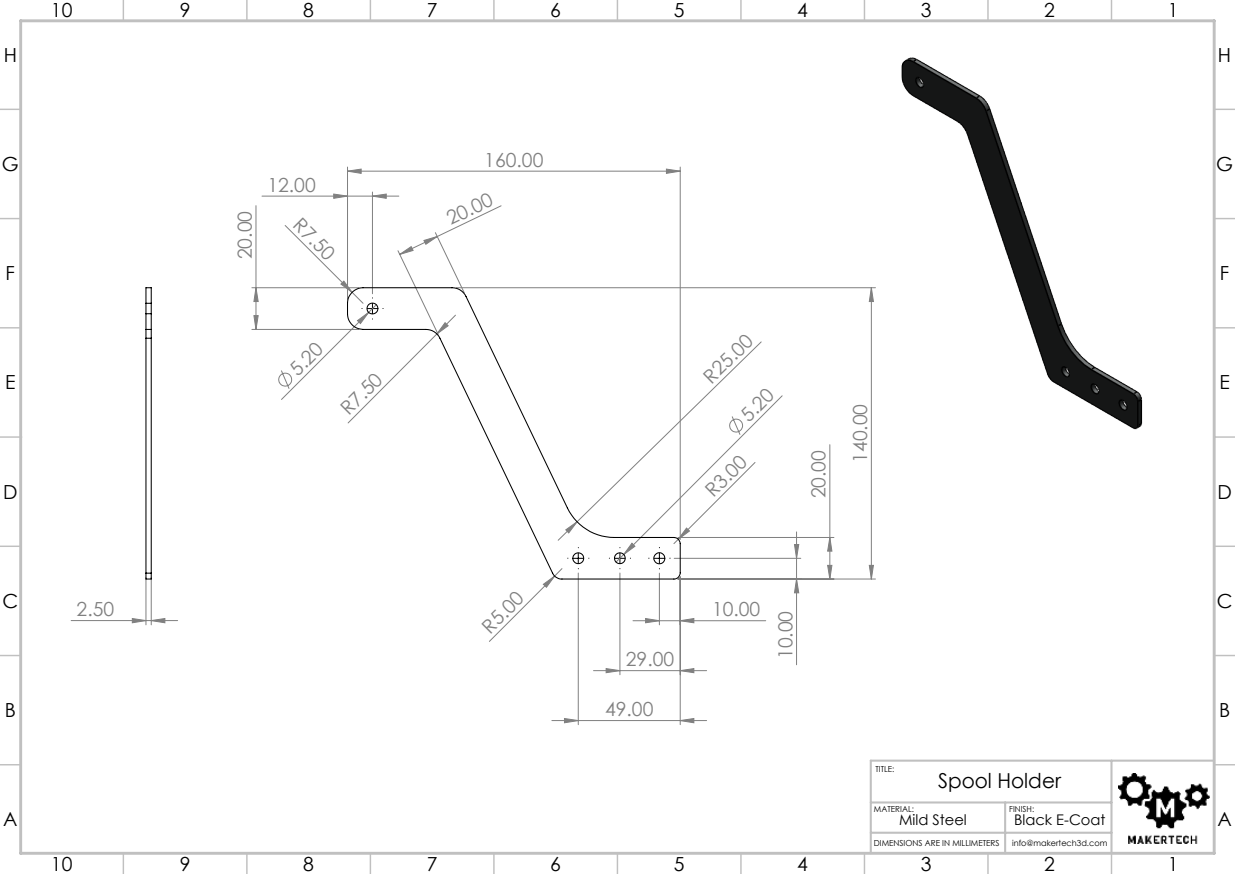
[picture p43: page 1]
Mild Steel

TITLE: Spool Holder

MATERIAL: | FINISH: Black E-Coat

DIMENSIONS ARE IN MILLIMETERS | info@makertech3d.com
