Makertech3D/Proforge-2S/Metal Parts/Support Beam.PDF

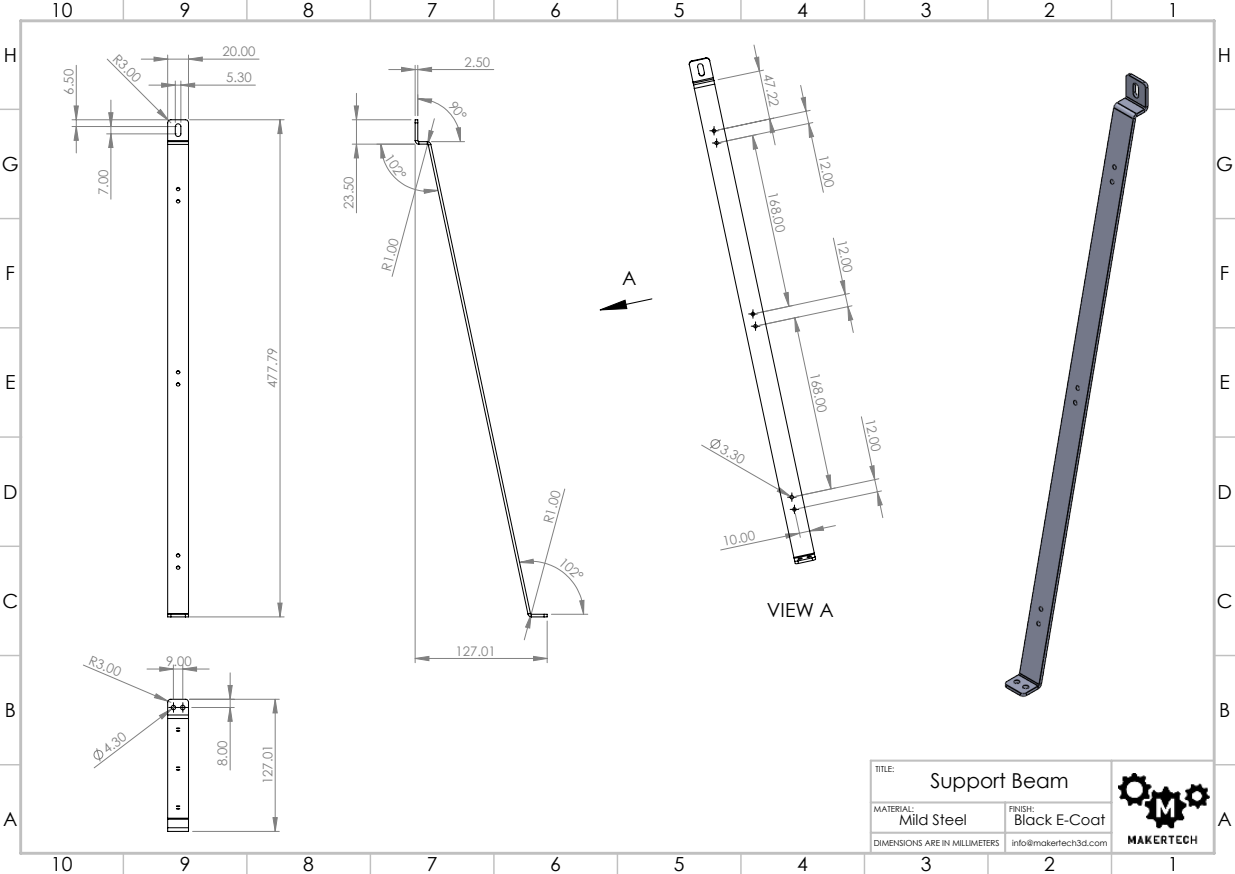
[picture p44: page 1]
VIEW A; Mild Steel

TITLE: Support Beam

MATERIAL: | FINISH: Black E-Coat

DIMENSIONS ARE IN MILLIMETERS | info@makertech3d.com
