Makertech3D/Proforge-2S/Metal Parts/Tool Carriage.PDF

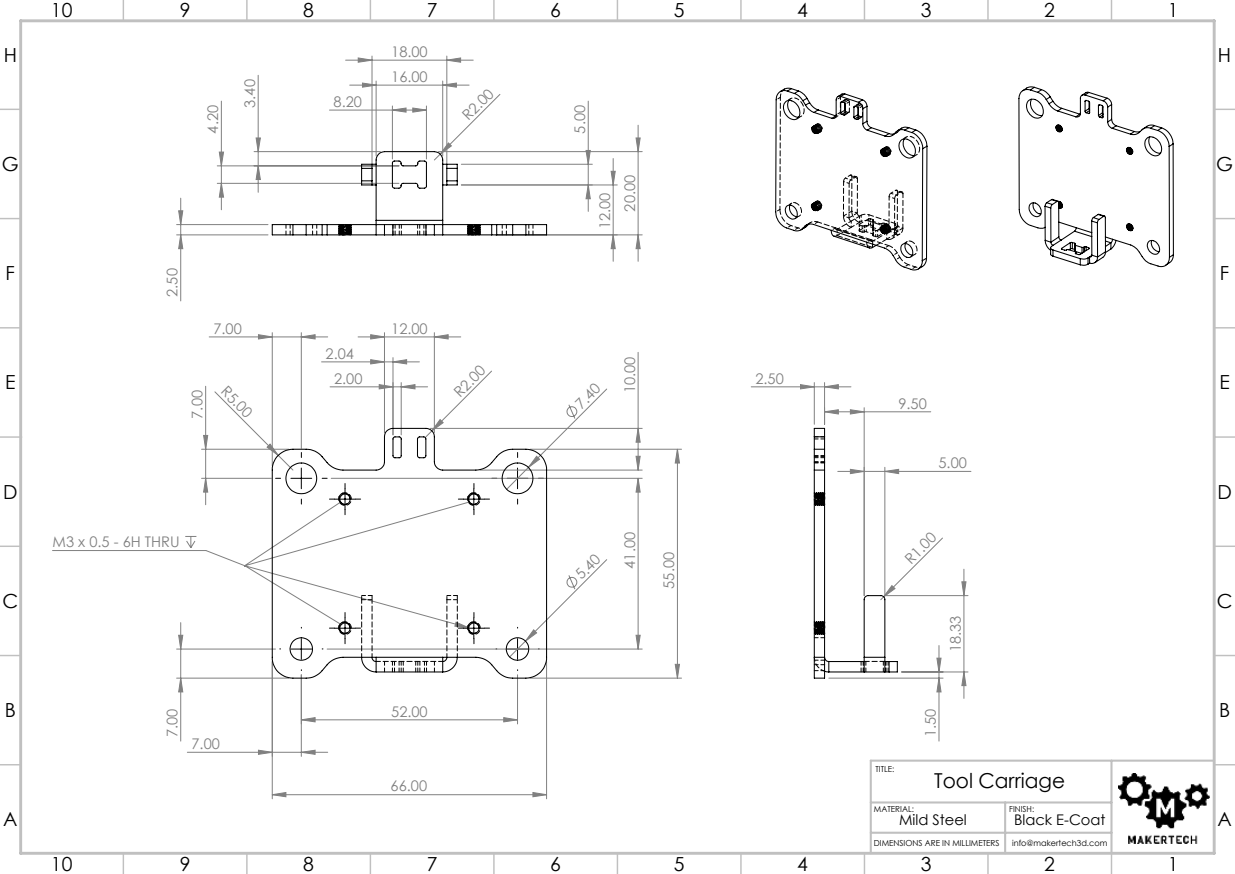
[picture p45: page 1]
M3 x 0.5 - 6H THRU; Mild Steel

TITLE: Tool Carriage

MATERIAL: | FINISH: Black E-Coat

DIMENSIONS ARE IN MILLIMETERS | info@makertech3d.com
