Makertech3D/Proforge-2S/Metal Parts/Y-Idler Guided.PDF

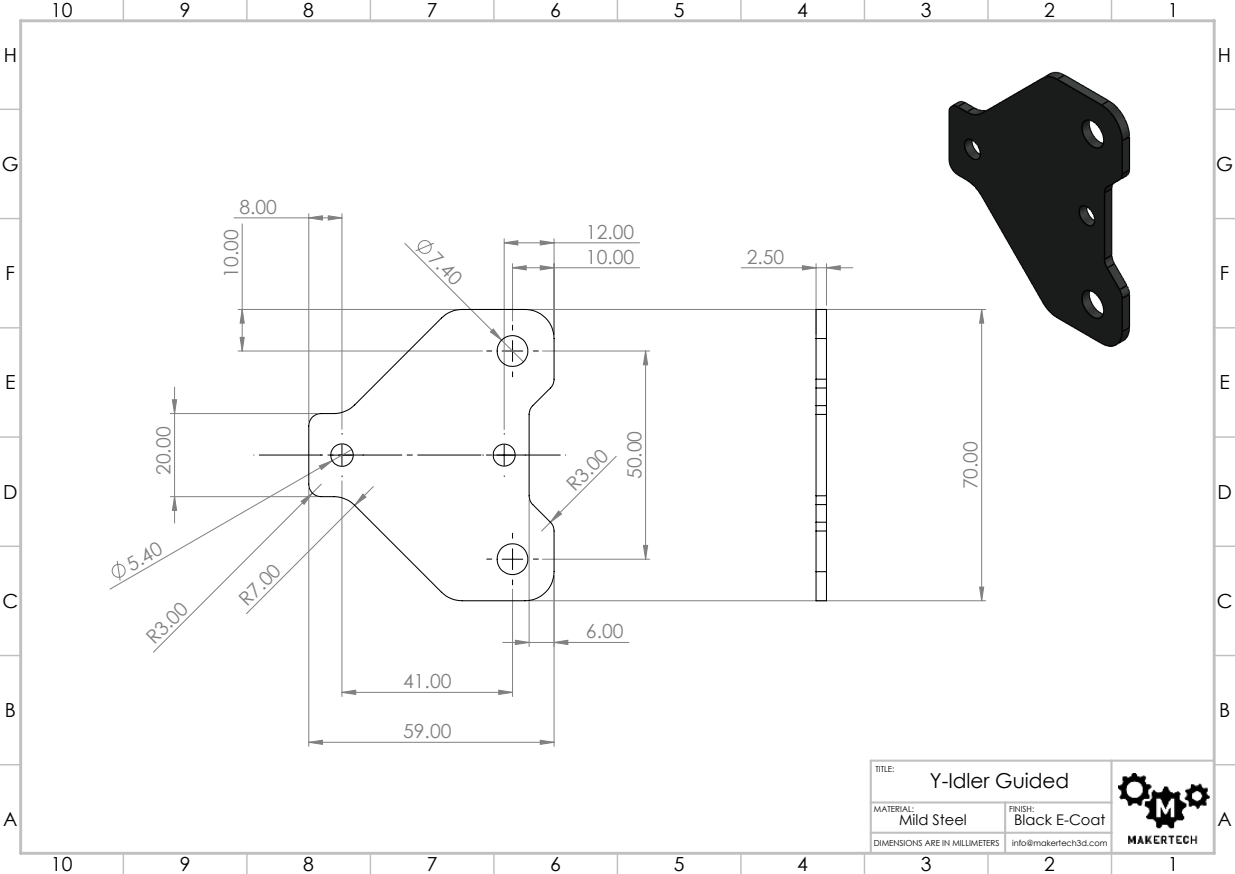
[picture p46: page 1]
Mild Steel

TITLE: Y-Idler Guided

MATERIAL: | FINISH: Black E-Coat

DIMENSIONS ARE IN MILLIMETERS | info@makertech3d.com
