Makertech3D/Proforge-2S/Metal Parts/Y-Idler Support Bracket.PDF

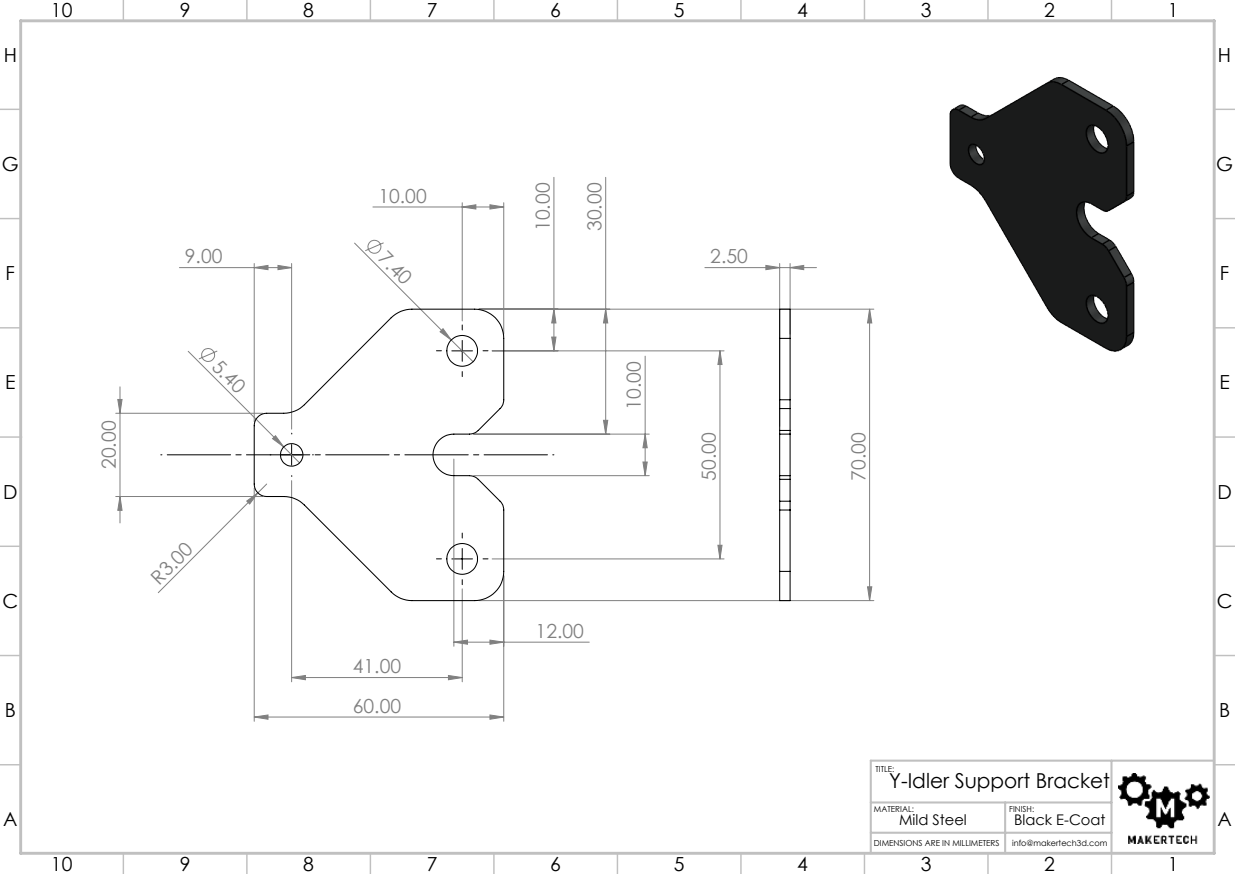
[picture p47: page 1]
Mild Steel

TITLE: Y-Idler Support Bracket

MATERIAL: | FINISH: Black E-Coat

DIMENSIONS ARE IN MILLIMETERS | info@makertech3d.com
