Makertech3D/Proforge-2S/Metal Parts/Y-Idler.PDF

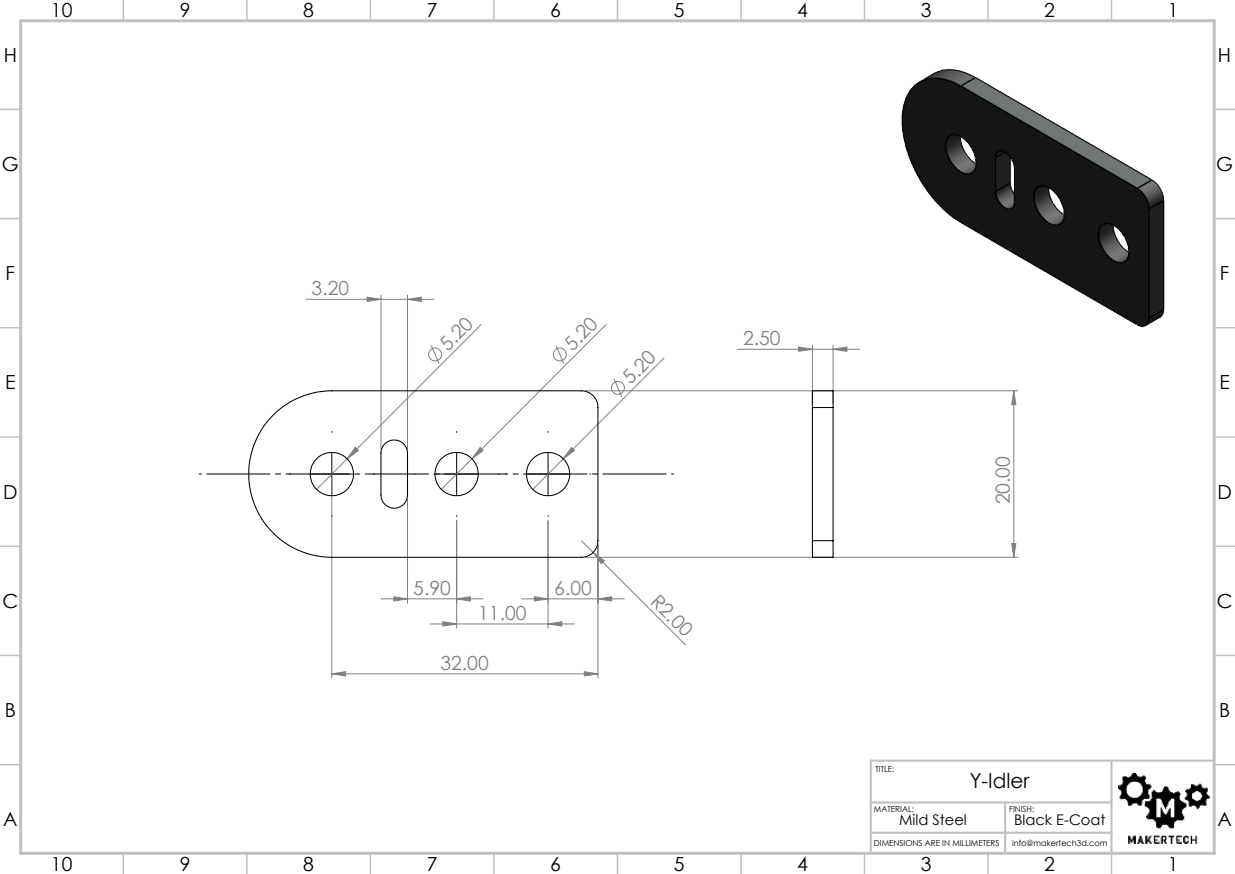
[picture p48: page 1]
Mild Steel

TITLE: Y-Idler

MATERIAL: | FINISH: Black E-Coat

DIMENSIONS ARE IN MILLIMETERS | info@makertech3d.com
