Makertech3D/Proforge-2S/Metal Parts/Z-Axis Bracket.PDF

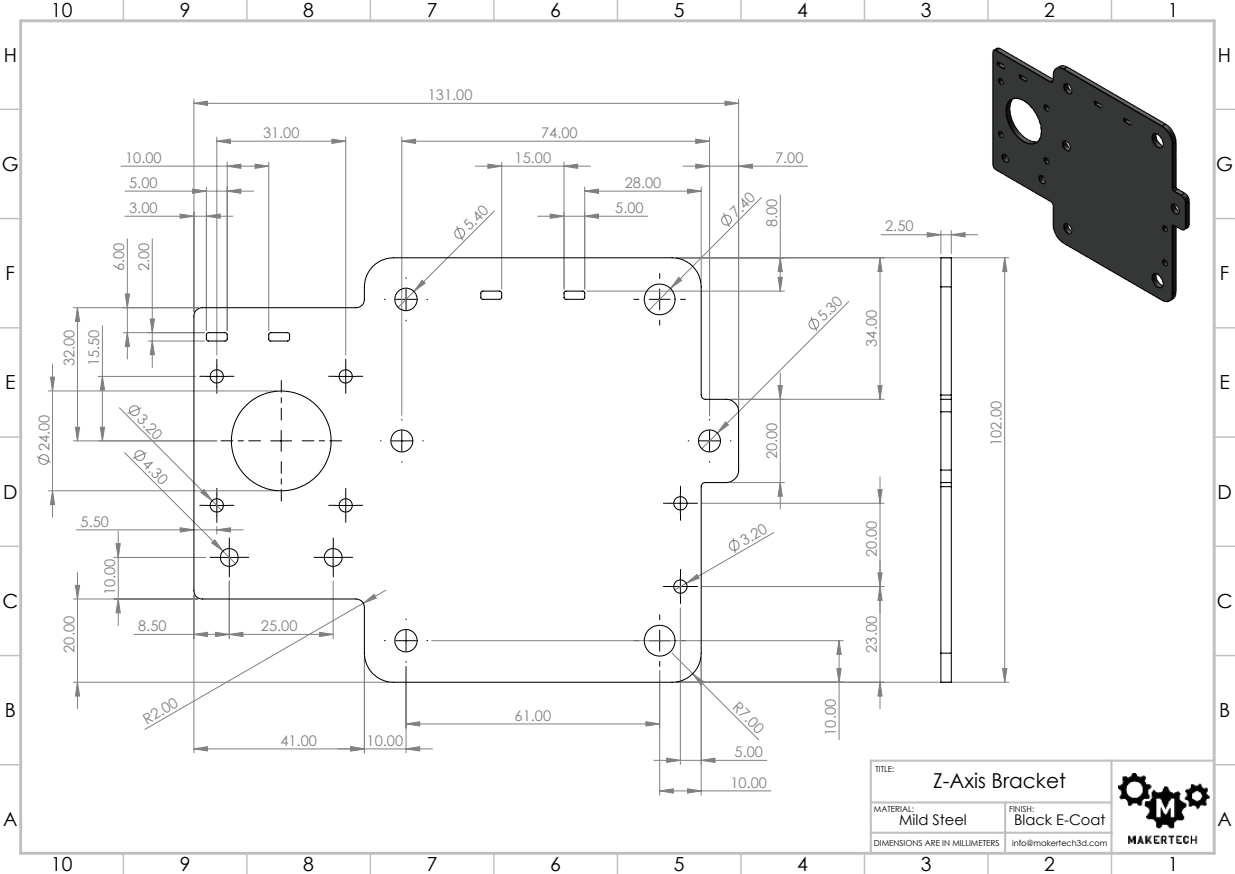
[picture p49: page 1]
Mild Steel

TITLE: Z-Axis Bracket

MATERIAL: | FINISH: Black E-Coat

DIMENSIONS ARE IN MILLIMETERS | info@makertech3d.com
