Makertech3D/Proforge-2S/Metal Parts/Z-Axis Support Bracket.PDF

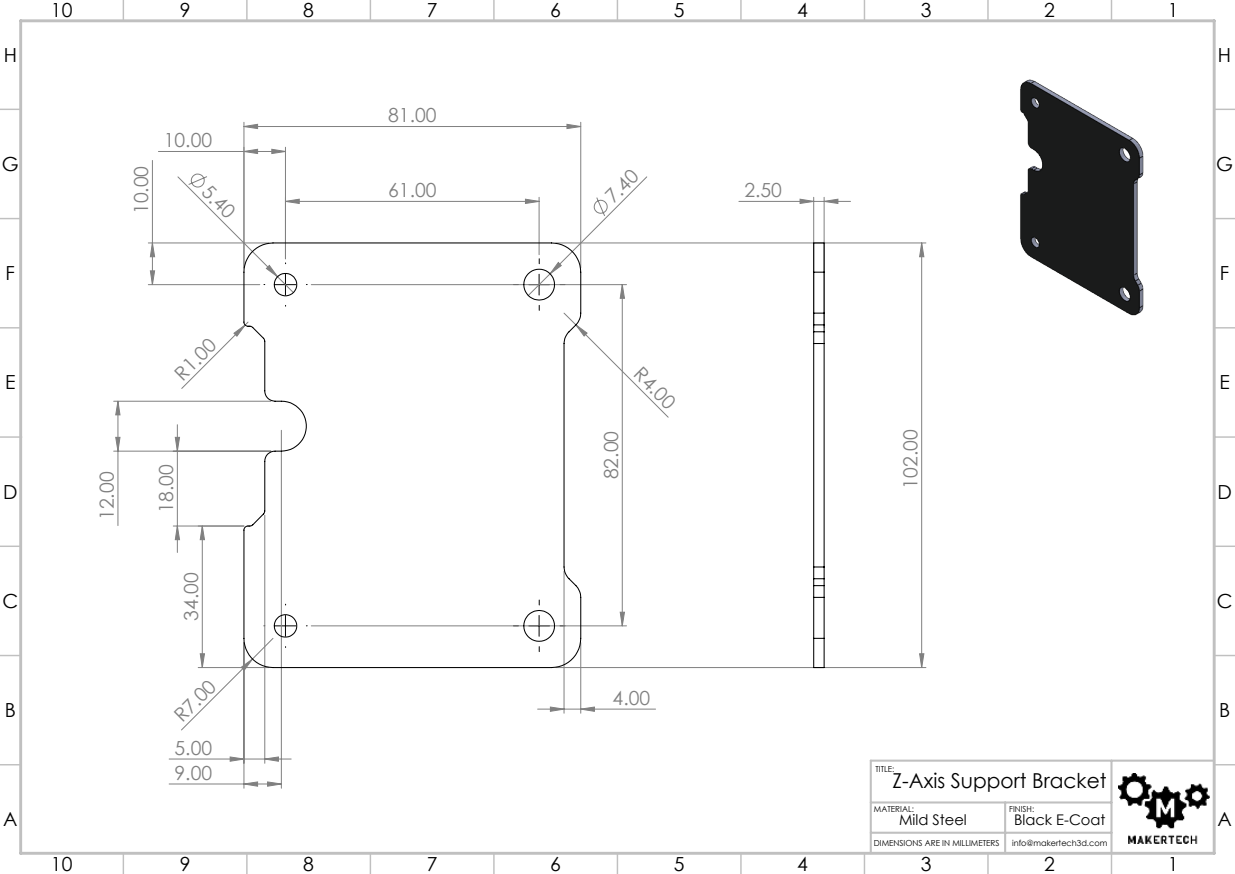
[picture p50: page 1]
Mild Steel

TITLE: Z-Axis Support Bracket

MATERIAL: | FINISH: Black E-Coat

DIMENSIONS ARE IN MILLIMETERS | info@makertech3d.com
